zanylane/obdii-gps-heads-up-display/README.md

# obdii-gps-heads-up-display
This was a box we made for senior design to integrate with a car's OBD-II port and an optional GPS to get speed for displaying on the windshield.
