zanylane/obdii-gps-heads-up-display/KiCad/BOM.pdf

Ref | Value | Part Number | Price @ 1000 Source
C1 | 10uF | 81-GRM21BR61E106KA3L | $0.13
C2 | .01uF | 581-06033A100K | $0.05
C3 | 100nF | 77-VJ0603V104ZXAPBC | $0.03
C4 | 100nF | 77-VJ0603V104ZXAPBC | $0.03
C5 | 100nF | 77-VJ0603V104ZXAPBC | $0.03
C6 | 220uF | 598-AVE227M10X16T-F | $0.07
C7 | 100nF | 77-VJ0603V104ZXAPBC | $0.03
C8 | 30pF | 80-C0603C300J5G | $0.01
C9 | 30pF | 80-C0603C300J5G | $0.01
C10 | 100nF | 77-VJ0603V104ZXAPBC | $0.03
C11 | 100nF | 77-VJ0603V104ZXAPBC | $0.03
C12 | 560pF | 81-GRM185C1E561JA01D | $0.02
C13 | 560pF | 81-GRM185C1E561JA01D | $0.02
C14 | 100nF | 77-VJ0603V104ZXAPBC | $0.03
C15 | 100nF | 77-VJ0603V104ZXAPBC | $0.03
C16 | 10uF | 81-GRM21BR61E106KA3L | $0.13
C17 | 100nF | 77-VJ0603V104ZXAPBC | $0.03
C18 | 100nF | 77-VJ0603V104ZXAPBC | $0.03
C19 | 10uF | 80-C0603C103K3R | $0.01
C20 | 30pF | 80-C0603C300J5G | $0.01
C21 | 30pF | 80-C0603C300J5G | $0.01
C22 | 30pF | 80-C0603C300J5G | $0.01
C23 | 30pF | 80-C0603C300J5G | $0.01
D1 | DIODE | 78-1N4148W-VGS18 | $0.04
D2 | DIODE | 78-1N4148W-VGS18 | $0.04
D3 | DIODE | 78-1N4148W-VGS18 | $0.04
D4 | 25V ZENER | 863-MMSZ4710T1G | $0.10
D5 | | 625-BD340A-E3/61T | $0.15
D6 | DIODE | 625-SRP300B-E3 | $0.15
D7 | DIODE | 625-SRP300B-E3 | $0.15
F1 | 3.6A | 576-2920L185 | $0.30
F2 | 1A | 576-1812L110PRT | $0.19
IC1 | ATMEGA328P-A | 556-ATMEGA328P-AU | $2.77
IC2 | SC16IS740 | 771-SC16IS740IPWQ900 | $1.40
IC3 | LM339 | 595-LM339PWR | $0.11
IC4 | LM317-8 | 863-LM317LDG | $0.14
IC5 | SCANTOOL | STN1110 | $7.99
IC6 | MCP2551 | 579-MCP2551-I/SN | $0.78
IC7 | TPS5430 | 595-TPS5430DDA | $2.99
IC8 | TPS77633 | 595-TPS77633D | $1.21
J1 | AVR-ISP-6 | 517-30306-6002HB | $0.29
J2
J3 | | 571-5555167-1 | $0.55
J3 | | 678-300268 | $0.29
J4 | User Interface | 798-DF3A-6P-2DS10 | $0.11
J4 | User Interface | 798-DF3-6S-2C | $0.06
J5 | | 798-DF3-4S-2C16 | $0.04
J5 | | 798-DF3A-4P-2DS10 | $0.08
J6 | DB9 | 152-3309 | $0.92

Mouser.com
Mouser.com
Mouser.com
Mouser.com
Mouser.com
Mouser.com
Mouser.com
Mouser.com
Mouser.com
Mouser.com
Mouser.com
Mouser.com
Mouser.com
Mouser.com
Mouser.com
Mouser.com
Mouser.com
Mouser.com
Mouser.com
Mouser.com
Mouser.com
Mouser.com
Mouser.com
Mouser.com
Mouser.com
Mouser.com
Mouser.com
40V 3A Schottky | Mouser.com
| Mouser.com
| Mouser.com
| Mouser.com
| Mouser.com
| Mouser.com
| Mouser.com
| Mouser.com
| Mouser.com
| Scantools.net
| Mouser.com
| Mouser.com
| Mouser.com
| Mouser.com
Spare Cnct Pts
RJ45 GPS Cnct | Mouser.com
RJ45 GPS Cnct | Mouser.com
| Mouser.com
| Mouser.com
Pwr Switch Cnct. | Mouser.com
Pwr Switch Cnct. | Mouser.com
| Mouser.com

J7 | LED Display | 517-30316-5002 | $0.66
J7 | | 517-3603/16 | $0.45
J7 | LED Display | 538-54597-1600 | $0.14
J8 | Power Jack | 806-KLDX-0202-A | $0.31
L1 | 10uH | 810-MLF1608E100M | $0.05
L2 | 100uH | 810-VLCF528T101MR332 | $0.64
LED1 | LED | 859-LTST-C190GKT | $0.04
LED2 | LED | 859-LTST-C190GKT | $0.04
LED3 | LED | 859-LTST-C190GKT | $0.04
LED4 | LED | 859-LTST-C190GKT | $0.04
LED5 | LED | 859-LTST-C190GKT | $0.04
Q1 | NPN | 512-MMBT3646 | $0.02
Q2 | MOSFET_N | 771-2N7002BK215 | $0.03
Q3 | PNP | 512-MMBT3640 | $0.20
Q4 | NPN | 512-MMBT3646 | $0.02
Q5 | NPN | 512-MMBT3906 | $0.01
Q6 | NPN | 512-MMBT3906 | $0.01
Q7 | NPN | 512-MMBT3646 | $0.02
Q8 | NPN | 512-MMBT3646 | $0.02
R1 | 3.24k | 71-TNPW06033K24BEEN | $0.41
R2 | 10k | 301-10K-RC | $0.00
R3 | 10K | 301-10K-RC | $0.00
R4 | 10K | 301-10K-RC | $0.00
R5 | 10K | 301-10K-RC | $0.00
R6 | 1k | 667-ERJ-3GEYJ102V | $0.00
R7 | 1k | 667-ERJ-3GEYJ102V | $0.00
R8 | 10K | 301-10K-RC | $0.00
R9 | 10K | 301-10K-RC | $0.00
R10 | 10K | 301-10K-RC | $0.00
R11 | 10K | 301-10K-RC | $0.00
R12 | 10K | 301-10K-RC | $0.00
R13 | 10K | 301-10K-RC | $0.00
R14 | 2K | 660-RK73B1JTTD202J | $0.02
R15 | 8K | 302-8.06K-RC | $0.02
R16 | 10K | 301-10K-RC | $0.00
R17 | 10K | 301-10K-RC | $0.00
R18 | 10K | 301-10K-RC | $0.00
R19 | 240 | 652-CR0603-JW-241ELF | $0.01
R20 | 866 | 71-CRCW0805-866-E3 | $0.02
R21 | 374 | 71-CRCW0603-374-E3 | $0.02
R22 | 10K | 301-10K-RC | $0.00
R23 | 2.2K | 652-CR0603-JW-222ELF | $0.01
R24 | 10K | 301-10K-RC | $0.00
R25 | 10K | 301-10K-RC | $0.00
R26 | 1k | 667-ERJ-3GEYJ102V | $0.00
R27 | 1k | 667-ERJ-3GEYJ102V | $0.00
R28 | 510 | 660-RK73B2ETTE511J | $0.07
R29 | 510 | 660-RK73B2ETTE511J | $0.07
R30 | 10k | 301-10K-RC | $0.00
R31 | 1k | 667-ERJ-3GEYJ102V | $0.00

Mouser.com
Disp. Ribbon Cable | Mouser.com
| Mouser.com
| Mouser.com
| Mouser.com
| Mouser.com
| Mouser.com
| Mouser.com
| Mouser.com
| Mouser.com
| Mouser.com
| Mouser.com
| Mouser.com
| Mouser.com
| Mouser.com
| Mouser.com
| Mouser.com
| Mouser.com
| Mouser.com
| Mouser.com
| Mouser.com
| Mouser.com
| Mouser.com
| Mouser.com
| Mouser.com
| Mouser.com
| Mouser.com
| Mouser.com
| Mouser.com
| Mouser.com
| Mouser.com
| Mouser.com
| Mouser.com
| Mouser.com
| Mouser.com
| Mouser.com
| Mouser.com
| Mouser.com
| Mouser.com
| Mouser.com
| Mouser.com
| Mouser.com
| Mouser.com
| Mouser.com
| Mouser.com
| Mouser.com
| Mouser.com
| Mouser.com
| Mouser.com
| Mouser.com

R32 | 4.7k | 71-CRCW0603J-4.7K-E3 | $0.02
R33 | 100 | 652-CR0603-JW-101GLF | $0.01
R34 | 100 | 652-CR0603-JW-101GLF | $0.01
R35 | 10k | 301-10K-RC | $0.00
R36 | 62k | 71-CRCW0603-62K-E3 | $0.02
R37 | 10k | 301-10K-RC | $0.00
R38 | 10 | 667-ERJ-3GEYJ100V | $0.00
R39 | 1k | 667-ERJ-3GEYJ102V | $0.00
R40 | 1k | 667-ERJ-3GEYJ102V | $0.00
R41 | 1k | 667-ERJ-3GEYJ102V | $0.00
R42 | 1k | 667-ERJ-3GEYJ102V | $0.00
R43 | 100k | 667-ERJ-3GEYJ104V | $0.00
R44 | 1k | 667-ERJ-3GEYJ102V | $0.00
R45 | 1.5k | 667-ERJ-3GEYJ152V | $0.00
R46 | 4.7k | 667-ERJ-3EKF2202V | $0.00
R47 | 10k | 301-10K-RC | $0.00
R48 | 10k | 301-10K-RC | $0.00
R49 | 1k | 667-ERJ-3GEYJ102V | $0.00
R50 | 1k | 667-ERJ-3GEYJ102V | $0.00
X1 | | 815-ABLS-16.0M-T | $0.15
X2 | | 815-ABLS-16.0M-T | $0.15
X3 | | 815-ABLS-14.7456M-T | $0.15
| Rotary Encoder | 652-PEC11-4220F-S24 | $0.77
| Power Switch | 629-AA211B31 | $0.49
| LED Display | DE-DP14112 | $23.90
$7.00 | estimate
Case Plastic | $2.00 | estimate

Mouser.com
Mouser.com
Mouser.com
Mouser.com
Mouser.com
Mouser.com
Mouser.com
Mouser.com
Mouser.com
Mouser.com
Mouser.com
Mouser.com
Mouser.com
Mouser.com
Mouser.com
Mouser.com
Mouser.com
Mouser.com
Mouser.com
16 MHz Xtal | Mouser.com
16 MHz Xtal | Mouser.com
14.7456 MHz Xtal | Mouser.com
| Mouser.com
| Mouser.com
| SureElectronics.net
Case Moulds
