zanylane/obdii-gps-heads-up-display/case/PowerSwitch.SLDPRT

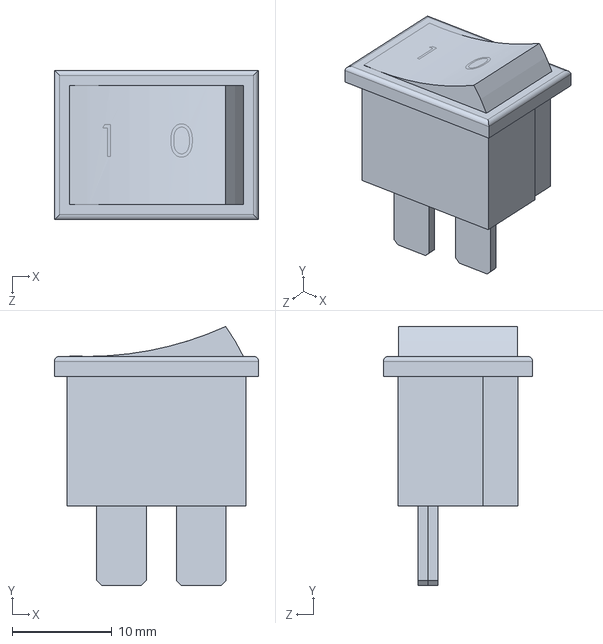
[picture p16: CAD file, 2018-04-19]
case/PowerSwitch.SLDPRT
20.5 x 26.0 x 15.0 mm
