zanylane/obdii-gps-heads-up-display/case/RotaryEncoderKnob.SLDPRT

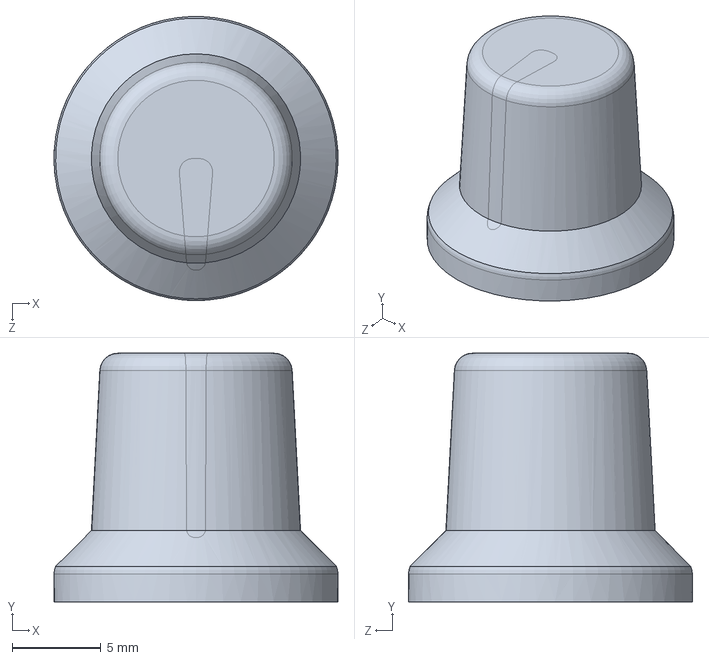
[picture p17: CAD file, 2018-04-19]
case/RotaryEncoderKnob.SLDPRT
16.0 x 14.0 x 16.0 mm
