zanylane/obdii-gps-heads-up-display/case/RotaryEncoder.SLDPRT

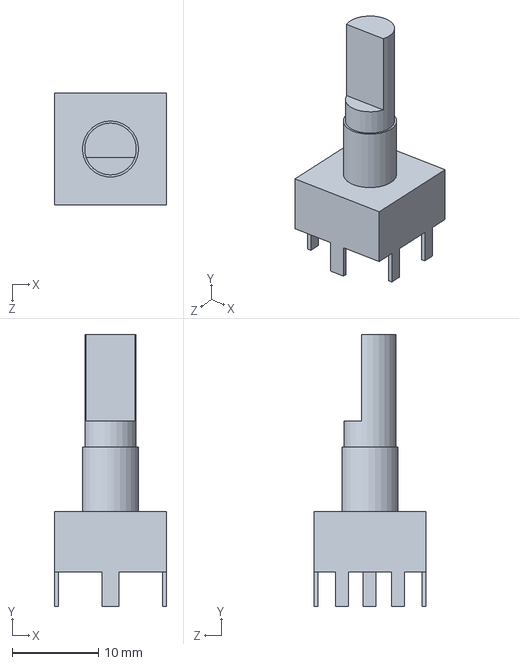
[picture p18: CAD file, 2018-04-19]
case/RotaryEncoder.SLDPRT
13.0 x 31.5 x 13.0 mm
