zanylane/obdii-gps-heads-up-display/(list of files, cad)

Other CAD files:
case/Assem1.SLDDRW
case/PowerSwitch.SLDDRW
case/RotaryEncoder.SLDDRW
case/RotaryEncoderKnob.SLDDRW
case/bottom.SLDDRW
case/box.SLDDRW
case/led_display.SLDDRW
case/pcb.SLDDRW
