zanylane/obdii-gps-heads-up-display/case/Assem1 - Sheet1.pdf

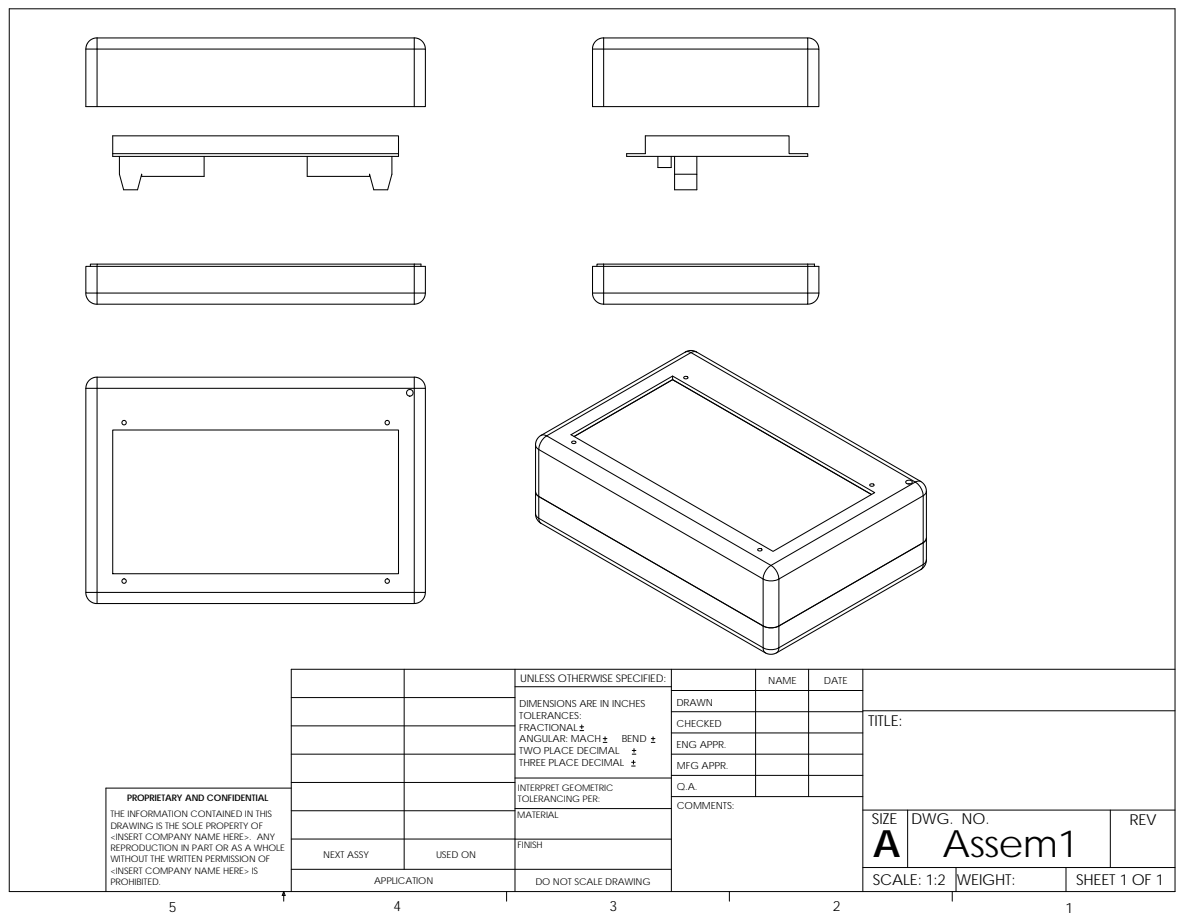
[picture p20: page 1]
COMMENTS:; BEND

UNLESS OTHERWISE SPECIFIED: | | NAME | DATE

DRAWN
CHECKED | | | TITLE:

DIMENSIONS ARE IN INCHES
TOLERANCES:
FRACTIONAL
ANGULAR: MACH
TWO PLACE DECIMAL
THREE PLACE DECIMAL

ENG APPR.
MFG APPR.

INTERPRET GEOMETRIC TOLERANCING PER: | Q.A.
MATERIAL | | SIZE A | DWG. NO. Assem1 | REV

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

NEXT ASSY | USED ON | FINISH
APPLICATION | DO NOT SCALE DRAWING | | SCALE: 1:2 | WEIGHT: | SHEET 1 OF 1
