zanylane/obdii-gps-heads-up-display/case/bottom - Sheet1&2.pdf

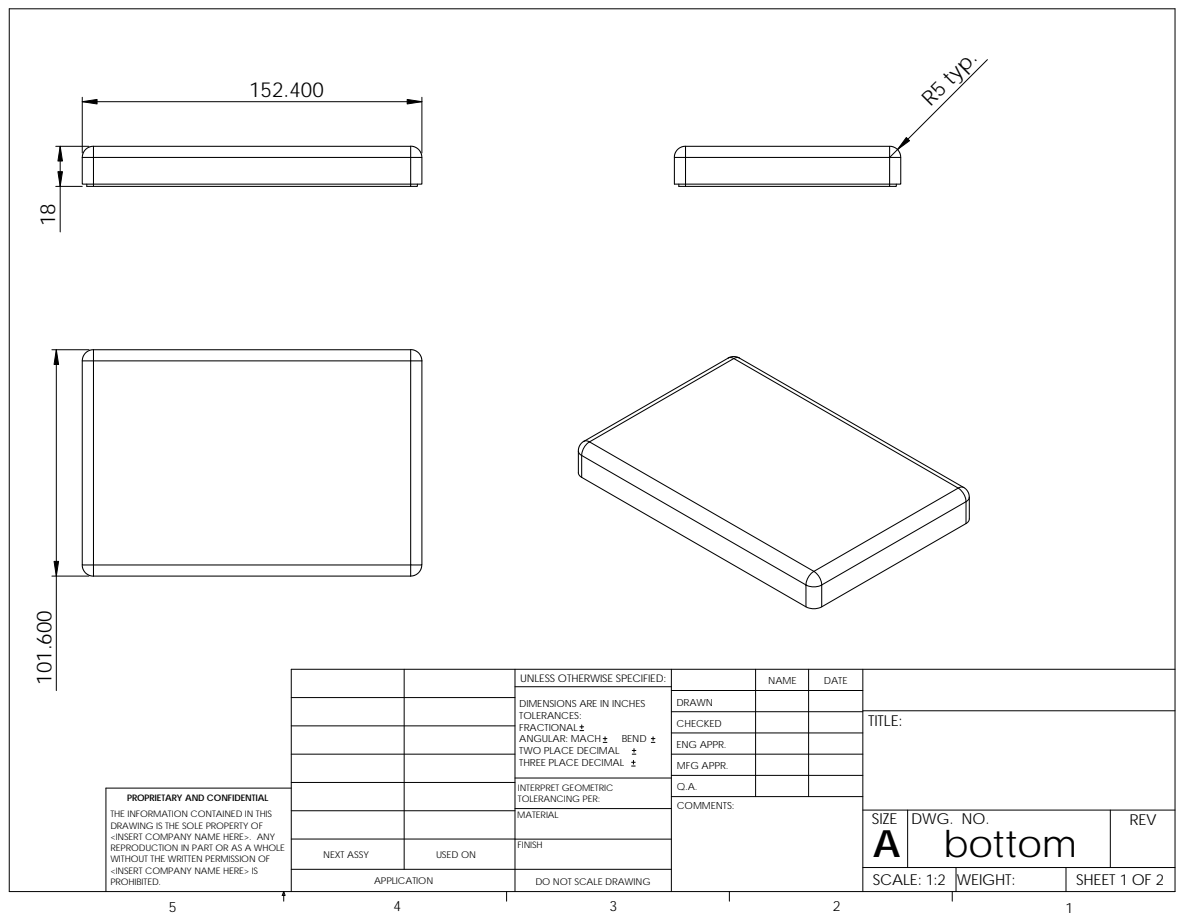
[picture p24: page 1]
R5 typ. 152.400; COMMENTS:; ANGULAR: MACH; BEND

UNLESS OTHERWISE SPECIFIED: | | NAME | DATE

DRAWN
CHECKED | | | TITLE:

DIMENSIONS ARE IN INCHES
TOLERANCES:
FRACTIONAL
TWO PLACE DECIMAL
THREE PLACE DECIMAL

ENG APPR.
MFG APPR.

INTERPRET GEOMETRIC TOLERANCING PER: | Q.A.
MATERIAL | | SIZE A | DWG. NO. bottom | REV

PROPRIETARY AND CONFIDENTIAL
THE INFORMATION CONTAINED IN THIS
DRAWING IS THE SOLE PROPERTY OF
<INSERT COMPANY NAME HERE>. ANY
REPRODUCTION IN PART OR AS A WHOLE
WITHOUT THE WRITTEN PERMISSION OF
<INSERT COMPANY NAME HERE> IS
PROHIBITED.

NEXT ASSY | USED ON | FINISH

APPLICATION | DO NOT SCALE DRAWING | | SCALE: 1:2 | WEIGHT: | SHEET 1 OF 2

1
B

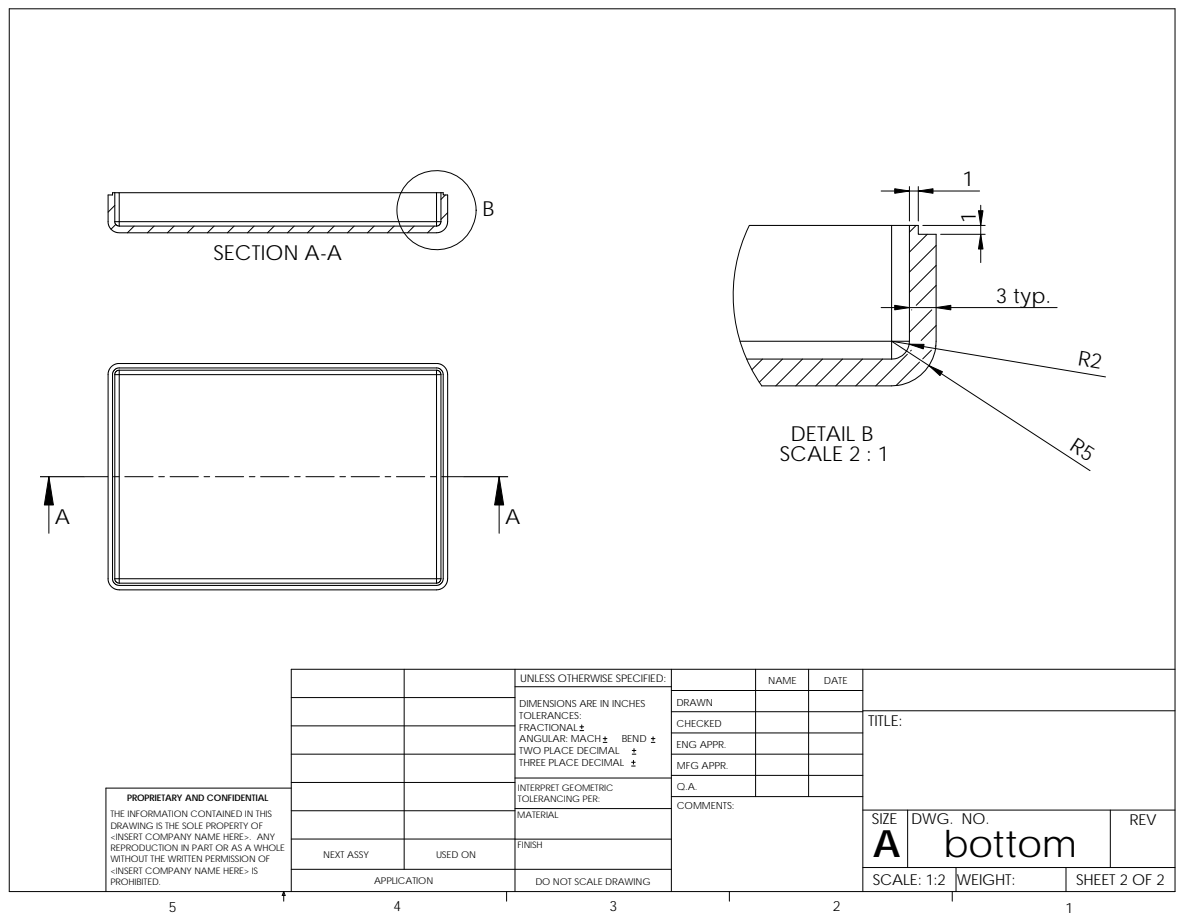
[picture p25: page 2]
DETAIL B SCALE 2 : 1; 3 typ.; COMMENTS:; ANGULAR: MACH; BEND; SECTION A-A

UNLESS OTHERWISE SPECIFIED: | | NAME | DATE

DRAWN
CHECKED | | | TITLE:

DIMENSIONS ARE IN INCHES
TOLERANCES:
FRACTIONAL
TWO PLACE DECIMAL
THREE PLACE DECIMAL

ENG APPR.
MFG APPR.

INTERPRET GEOMETRIC TOLERANCING PER: | Q.A.
MATERIAL | | SIZE A | DWG. NO. bottom | REV

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

NEXT ASSY | USED ON | FINISH

APPLICATION | DO NOT SCALE DRAWING | | SCALE: 1:2 | WEIGHT: | SHEET 2 OF 2
