zanylane/obdii-gps-heads-up-display/case/box_top - Sheet1&2.pdf

152.400 | R5

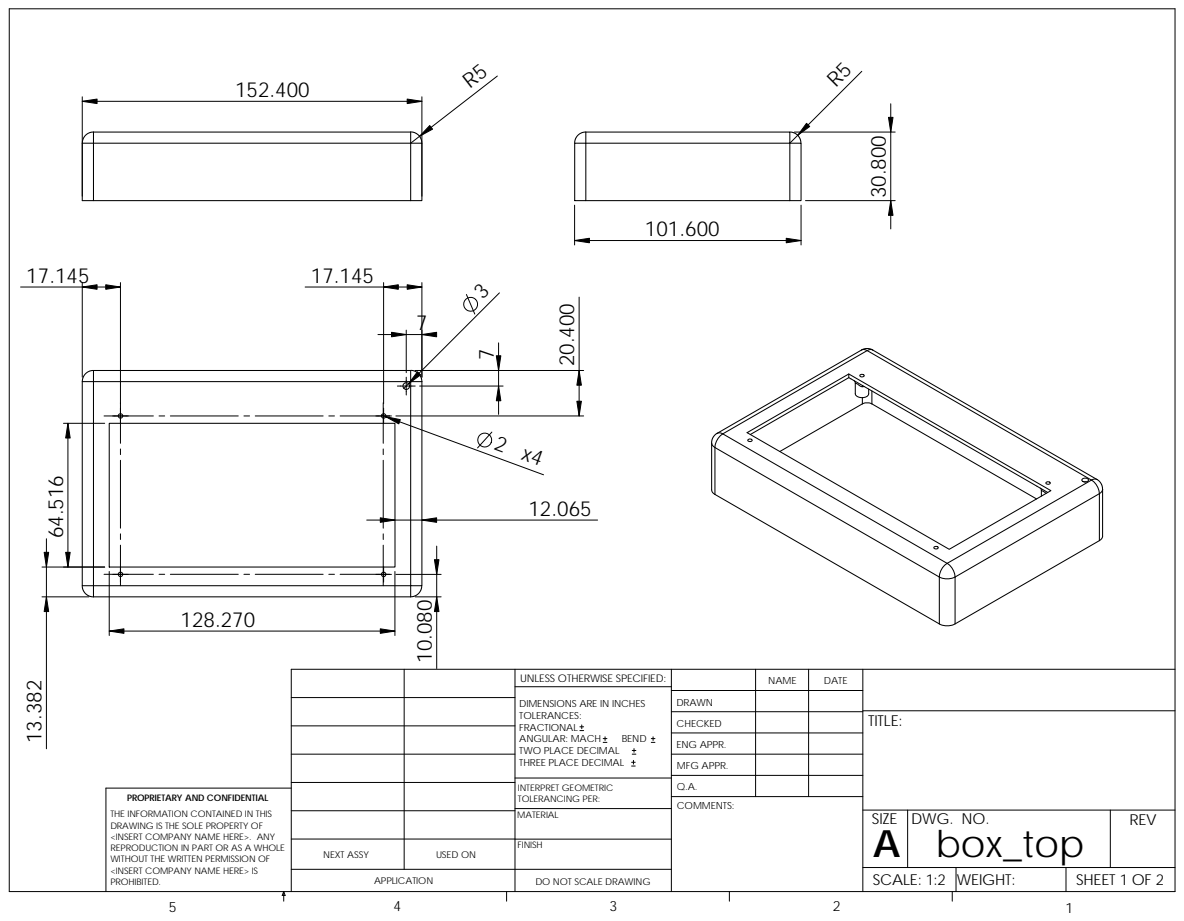
[picture p26: page 1]
COMMENTS:; BEND

UNLESS OTHERWISE SPECIFIED: | | NAME | DATE

DRAWN
CHECKED | | | TITLE:

DIMENSIONS ARE IN INCHES
TOLERANCES:
FRACTIONAL
ANGULAR: MACH
TWO PLACE DECIMAL
THREE PLACE DECIMAL

ENG APPR.
MFG APPR.

INTERPRET GEOMETRIC TOLERANCING PER: | Q.A.
MATERIAL | | SIZE A | DWG. NO. box_top | REV

PROPRIETARY AND CONFIDENTIAL
THE INFORMATION CONTAINED IN THIS
DRAWING IS THE SOLE PROPERTY OF
<INSERT COMPANY NAME HERE>. ANY
REPRODUCTION IN PART OR AS A WHOLE
WITHOUT THE WRITTEN PERMISSION OF
<INSERT COMPANY NAME HERE> IS
PROHIBITED.

NEXT ASSY | USED ON | FINISH

APPLICATION | DO NOT SCALE DRAWING | | SCALE: 1:2 | WEIGHT: | SHEET 1 OF 2

# SECTION A-A

# 2 typ thickness

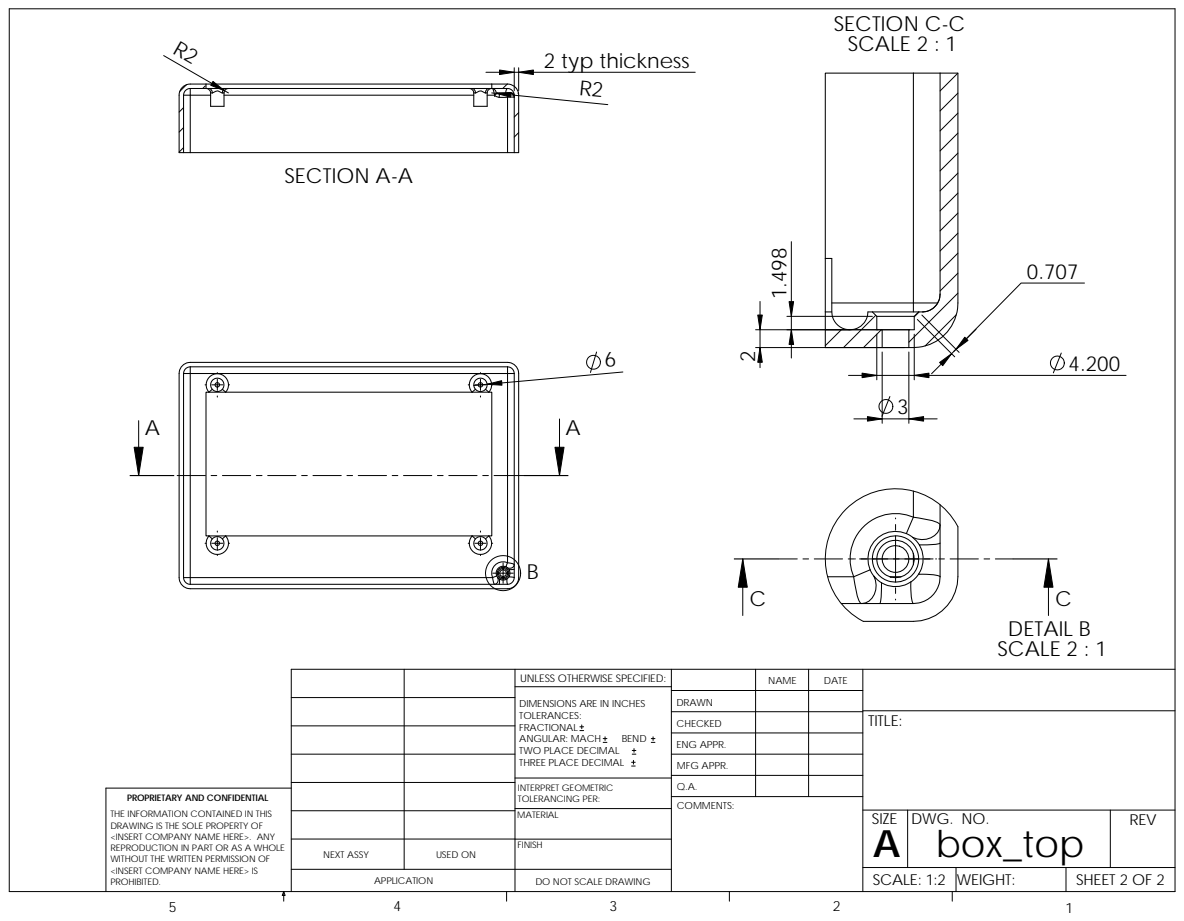
[picture p27: page 2]
COMMENTS:; BEND; SECTION C-C SCALE 2 : 1; DETAIL B SCALE 2 : 1

UNLESS OTHERWISE SPECIFIED: | | NAME | DATE

DRAWN
CHECKED | | | TITLE:

DIMENSIONS ARE IN INCHES
TOLERANCES:
FRACTIONAL
ANGULAR: MACH
TWO PLACE DECIMAL
THREE PLACE DECIMAL

ENG APPR.
MFG APPR.

INTERPRET GEOMETRIC TOLERANCING PER: | Q.A.
MATERIAL | | SIZE A | DWG. NO. box_top | REV

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

NEXT ASSY | USED ON | FINISH
APPLICATION | DO NOT SCALE DRAWING | | SCALE: 1:2 | WEIGHT: | SHEET 2 OF 2
