zanylane/obdii-gps-heads-up-display/KiCad/GPS_Module.sch

## KiCad design KiCad/GPS_Module.sch (2018-04-19)

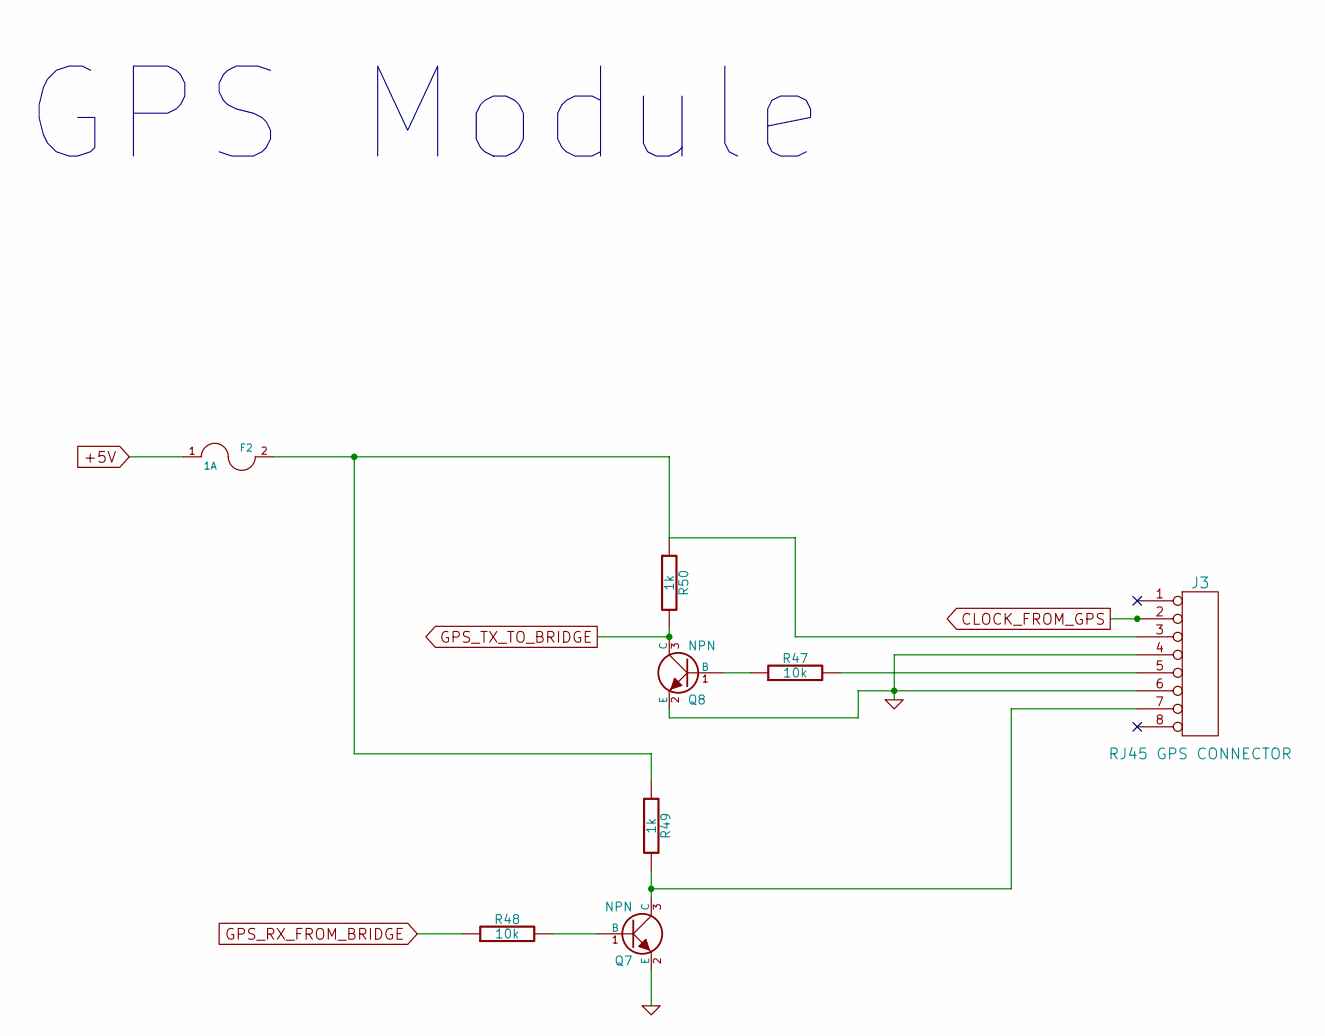
[picture p39: schematic GPS_Module.sch]

Parts:
F2: 1A
J3: RJ45 GPS CONNECTOR
Q7, Q8: NPN
R47, R48: 10k
R49, R50: 1k

Connections:
+5V: F2.1
CLOCK_FROM_GPS: J3.2
GND: J3.4, J3.6, Q7.2 (E), Q8.2 (E)
GPS_RX_FROM_BRIDGE: R48.1
GPS_TX_TO_BRIDGE: Q8.3 (C), R50.2
unnamed: F2.2, J3.3, R49.1, R50.1
unnamed: J3.5, R47.2
unnamed: J3.7, Q7.3 (C), R49.2
unnamed: Q7.1 (B), R48.2
unnamed: Q8.1 (B), R47.1

Notes on the sheet:
GPS Module
