zanylane/obdii-gps-heads-up-display/KiCad/I2C_Bridge.sch

## KiCad design KiCad/I2C_Bridge.sch (2018-04-19)

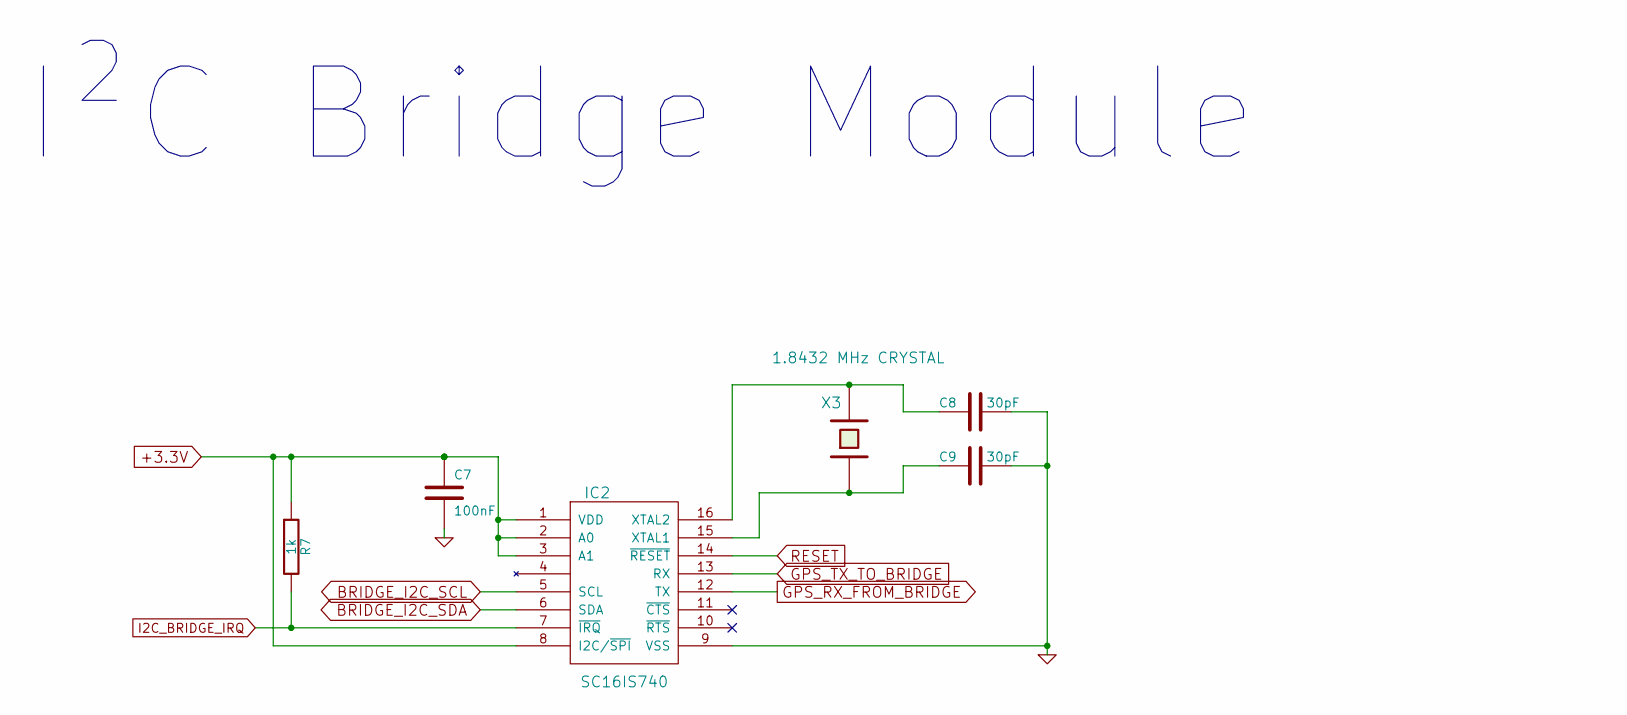
[picture p40: schematic I2C_Bridge.sch]

Parts:
C7: 100nF
C8, C9: 30pF
IC2: SC16IS740
R7: 1k
X3: 1.8432 MHz CRYSTAL

Connections:
+3.3V: C7.1, IC2.1 (VDD), IC2.2 (A0), IC2.3 (A1), IC2.8 (I2C/~SPI), R7.1
BRIDGE_I2C_SCL: IC2.5 (SCL)
BRIDGE_I2C_SDA: IC2.6 (SDA)
GND: C7.2, C8.2, C9.2, IC2.9 (VSS)
GPS_RX_FROM_BRIDGE: IC2.12 (TX)
GPS_TX_TO_BRIDGE: IC2.13 (RX)
I2C_BRIDGE_IRQ: IC2.7 (~IRQ), R7.2
unnamed: C8.1, IC2.16 (XTAL2), X3.2
unnamed: C9.1, IC2.15 (XTAL1), X3.1
RESET: IC2.14 (~RESET)

Notes on the sheet:
I²C Bridge Module
