zanylane/obdii-gps-heads-up-display/KiCad/Microprocessor.sch

## KiCad design KiCad/Microprocessor.sch (2018-04-19)

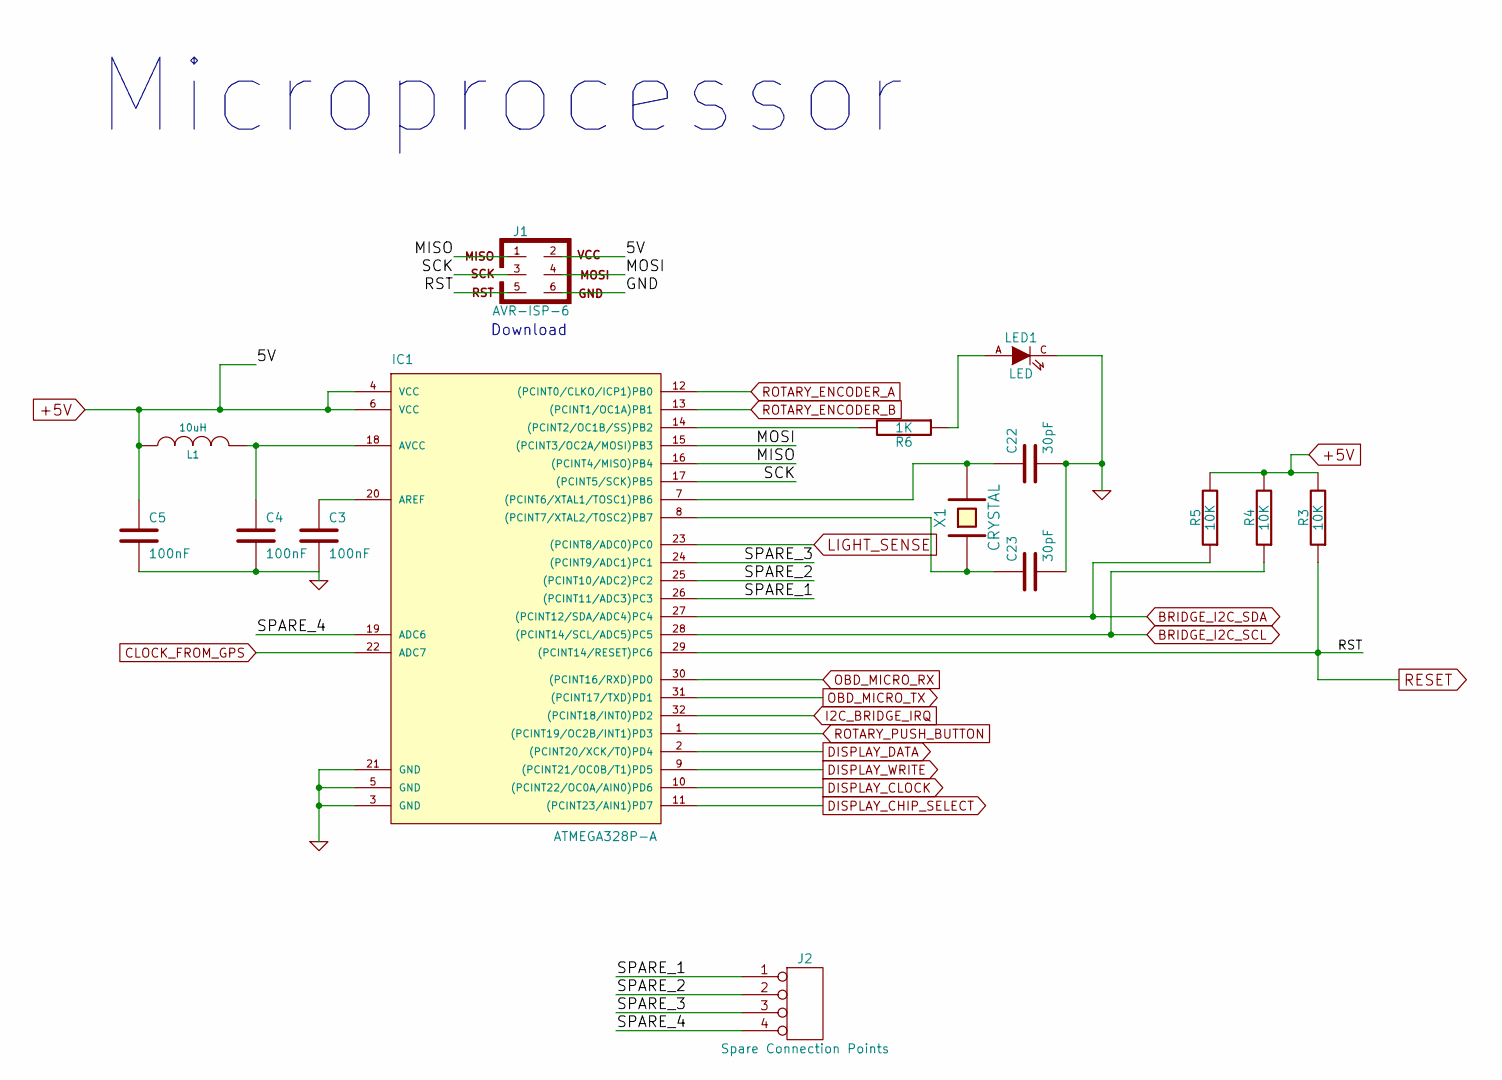
[picture p41: schematic Microprocessor.sch]

Parts:
C3, C4, C5: 100nF
C22, C23: 30pF
IC1: ATMEGA328P-A; TQFP32
J1: AVR-ISP-6
J2: Spare Connection Points
L1: 10uH
LED1: LED
R3, R4, R5: 10K
R6: 1K
X1: CRYSTAL

Connections:
+5V: C5.1, IC1.4 (VCC), IC1.6 (VCC), J1.2, L1.1, R3.2, R4.2, R5.2
BRIDGE_I2C_SCL: IC1.28 ((PCINT14/SCL/ADC5)PC5), R4.1
BRIDGE_I2C_SDA: IC1.27 ((PCINT12/SDA/ADC4)PC4), R5.1
CLOCK_FROM_GPS: IC1.22 (ADC7)
DISPLAY_CHIP_SELECT: IC1.11 ((PCINT23/AIN1)PD7)
DISPLAY_CLOCK: IC1.10 ((PCINT22/OC0A/AIN0)PD6)
DISPLAY_DATA: IC1.2 ((PCINT20/XCK/T0)PD4)
DISPLAY_WRITE: IC1.9 ((PCINT21/OC0B/T1)PD5)
GND: C3.2, C4.2, C5.2, C22.2, C23.2, IC1.3 (GND), IC1.5 (GND), IC1.21 (GND), J1.6, LED1.C
I2C_BRIDGE_IRQ: IC1.32 ((PCINT18/INT0)PD2)
LIGHT_SENSE: IC1.23 ((PCINT8/ADC0)PC0)
MISO: IC1.16 ((PCINT4/MISO)PB4), J1.1
MOSI: IC1.15 ((PCINT3/OC2A/MOSI)PB3), J1.4
unnamed: C3.1, IC1.20 (AREF)
unnamed: C4.1, IC1.18 (AVCC), L1.2
unnamed: C22.1, IC1.7 ((PCINT6/XTAL1/TOSC1)PB6), X1.2
unnamed: C23.1, IC1.8 ((PCINT7/XTAL2/TOSC2)PB7), X1.1
unnamed: IC1.14 ((PCINT2/OC1B/SS)PB2), R6.2
unnamed: LED1.A, R6.1
OBD_MICRO_RX: IC1.30 ((PCINT16/RXD)PD0)
OBD_MICRO_TX: IC1.31 ((PCINT17/TXD)PD1)
RESET: IC1.29 ((PCINT14/RESET)PC6), J1.5, R3.1
ROTARY_ENCODER_A: IC1.12 ((PCINT0/CLKO/ICP1)PB0)
ROTARY_ENCODER_B: IC1.13 ((PCINT1/OC1A)PB1)
ROTARY_PUSH_BUTTON: IC1.1 ((PCINT19/OC2B/INT1)PD3)
SCK: IC1.17 ((PCINT5/SCK)PB5), J1.3
SPARE_1: IC1.26 ((PCINT11/ADC3)PC3), J2.1
SPARE_2: IC1.25 ((PCINT10/ADC2)PC2), J2.2
SPARE_3: IC1.24 ((PCINT9/ADC1)PC1), J2.3
SPARE_4: IC1.19 (ADC6), J2.4

Notes on the sheet:
Microprocessor
Download
