zanylane/obdii-gps-heads-up-display/KiCad/OBD_Chip.sch

## KiCad design KiCad/OBD_Chip.sch (2018-04-19)

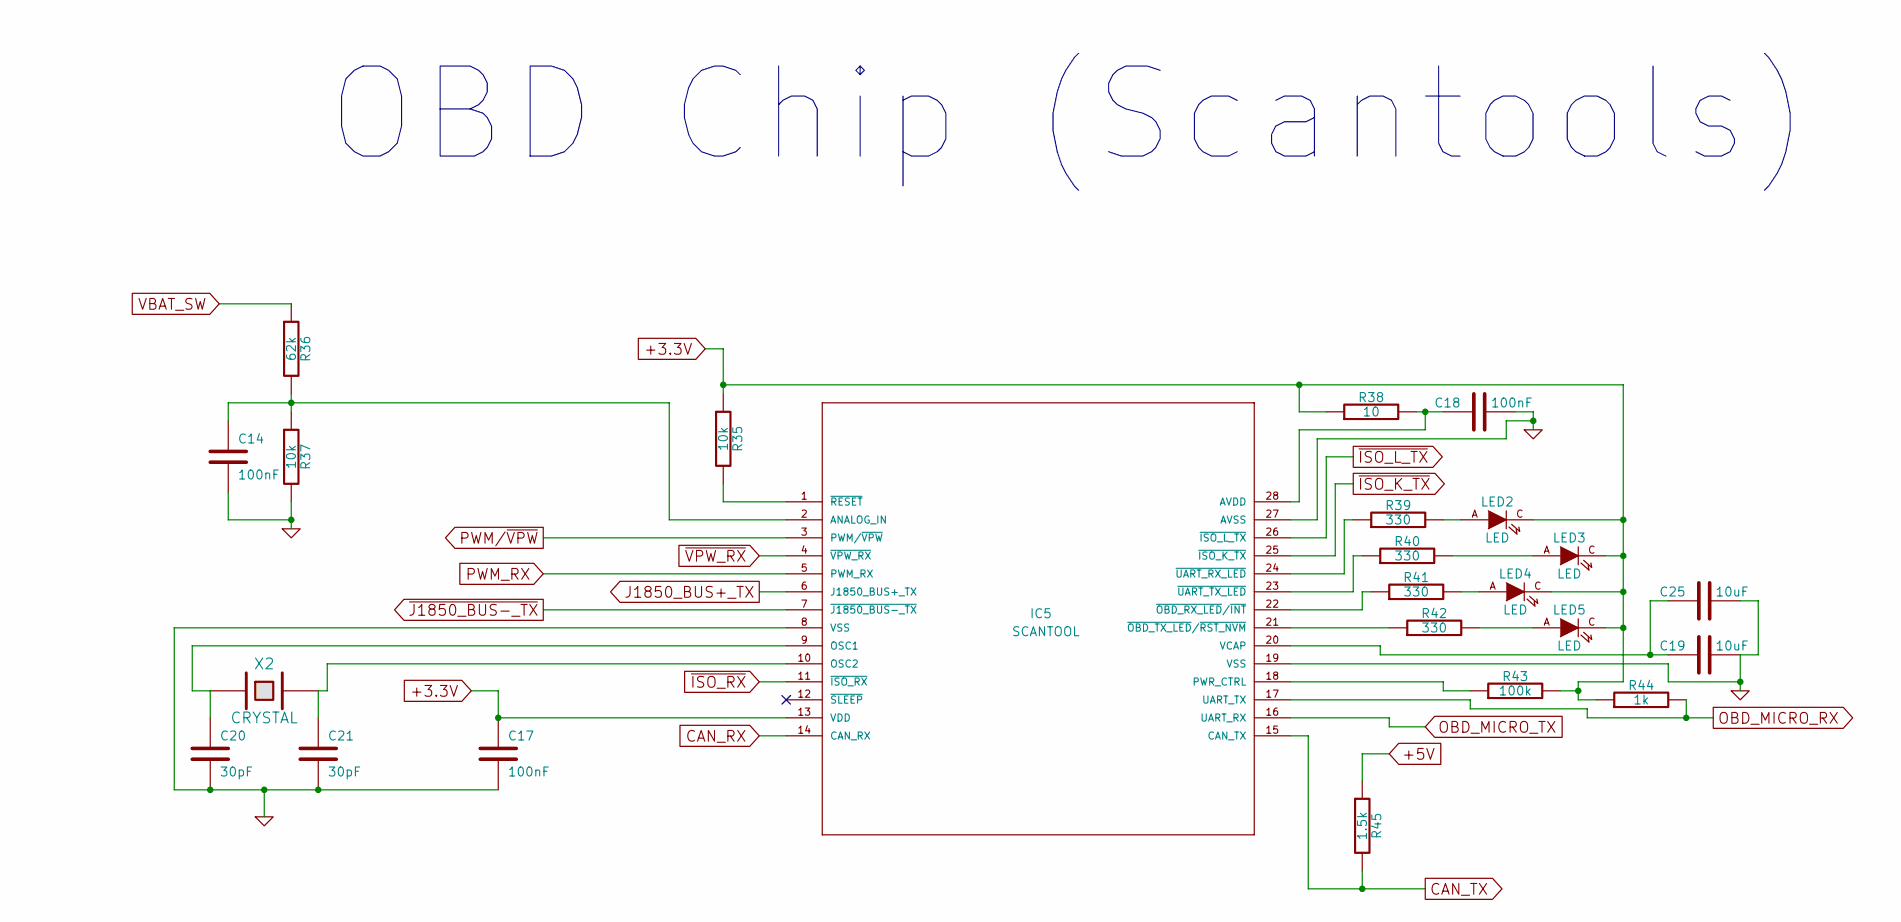
[picture p42: schematic OBD_Chip.sch]

Parts:
C14, C17, C18: 100nF
C19, C25: 10uF
C20, C21: 30pF
IC5: SCANTOOL; STN1110_-_SCANTOOL_SOIC
LED2, LED3, LED4, LED5: LED
R35, R37: 10k
R36: 62k
R38: 10
R39, R40, R41, R42: 330
R43: 100k
R44: 1k
R45: 1.5k
X2: CRYSTAL

Connections:
+3.3V: C17.1, IC5.13 (VDD), LED2.C, LED3.C, LED4.C, LED5.C, R35.1, R38.1, R43.2, R44.1
+5V: R45.1
CAN_RX: IC5.14 (CAN_RX)
CAN_TX: IC5.15 (CAN_TX), R45.2
GND: C14.2, C17.2, C18.2, C19.2, C20.2, C21.2, C25.2, IC5.8 (VSS), IC5.19 (VSS), IC5.27 (AVSS), R37.2
J1850_BUS+_TX: IC5.6 (J1850_BUS+_TX)
unnamed: C14.1, IC5.2 (ANALOG_IN), R36.2, R37.1
unnamed: C18.1, IC5.28 (AVDD), R38.2
unnamed: C19.1, C25.1, IC5.20 (VCAP)
unnamed: C20.1, IC5.9 (OSC1), X2.1
unnamed: C21.1, IC5.10 (OSC2), X2.2
unnamed: IC5.1 (~RESET), R35.2
unnamed: IC5.18 (PWR_CTRL), R43.1
unnamed: IC5.21 (~OBD_TX_LED~/~RST_NVM), R42.1
unnamed: IC5.22 (~OBD_RX_LED~/~INT), R41.1
unnamed: IC5.23 (~UART_TX_LED), R40.1
unnamed: IC5.24 (~UART_RX_LED), R39.1
unnamed: LED2.A, R39.2
unnamed: LED3.A, R40.2
unnamed: LED4.A, R41.2
unnamed: LED5.A, R42.2
OBD_MICRO_RX: IC5.17 (UART_TX), R44.2
OBD_MICRO_TX: IC5.16 (UART_RX)
PWM/~VPW: IC5.3 (PWM/~VPW)
PWM_RX: IC5.5 (PWM_RX)
VBAT_SW: R36.1
~ISO_K_TX: IC5.25 (~ISO_K_TX)
~ISO_L_TX: IC5.26 (~ISO_L_TX)
~ISO_RX: IC5.11 (~ISO_RX)
~J1850_BUS-_TX: IC5.7 (~J1850_BUS-_TX)
~VPW_RX: IC5.4 (~VPW_RX)

Notes on the sheet:
OBD Chip (Scantools)
