zanylane/obdii-gps-heads-up-display/KiCad/OBD_Voltage_Shifter1.sch

## KiCad design KiCad/OBD_Voltage_Shifter1.sch (2018-04-19)

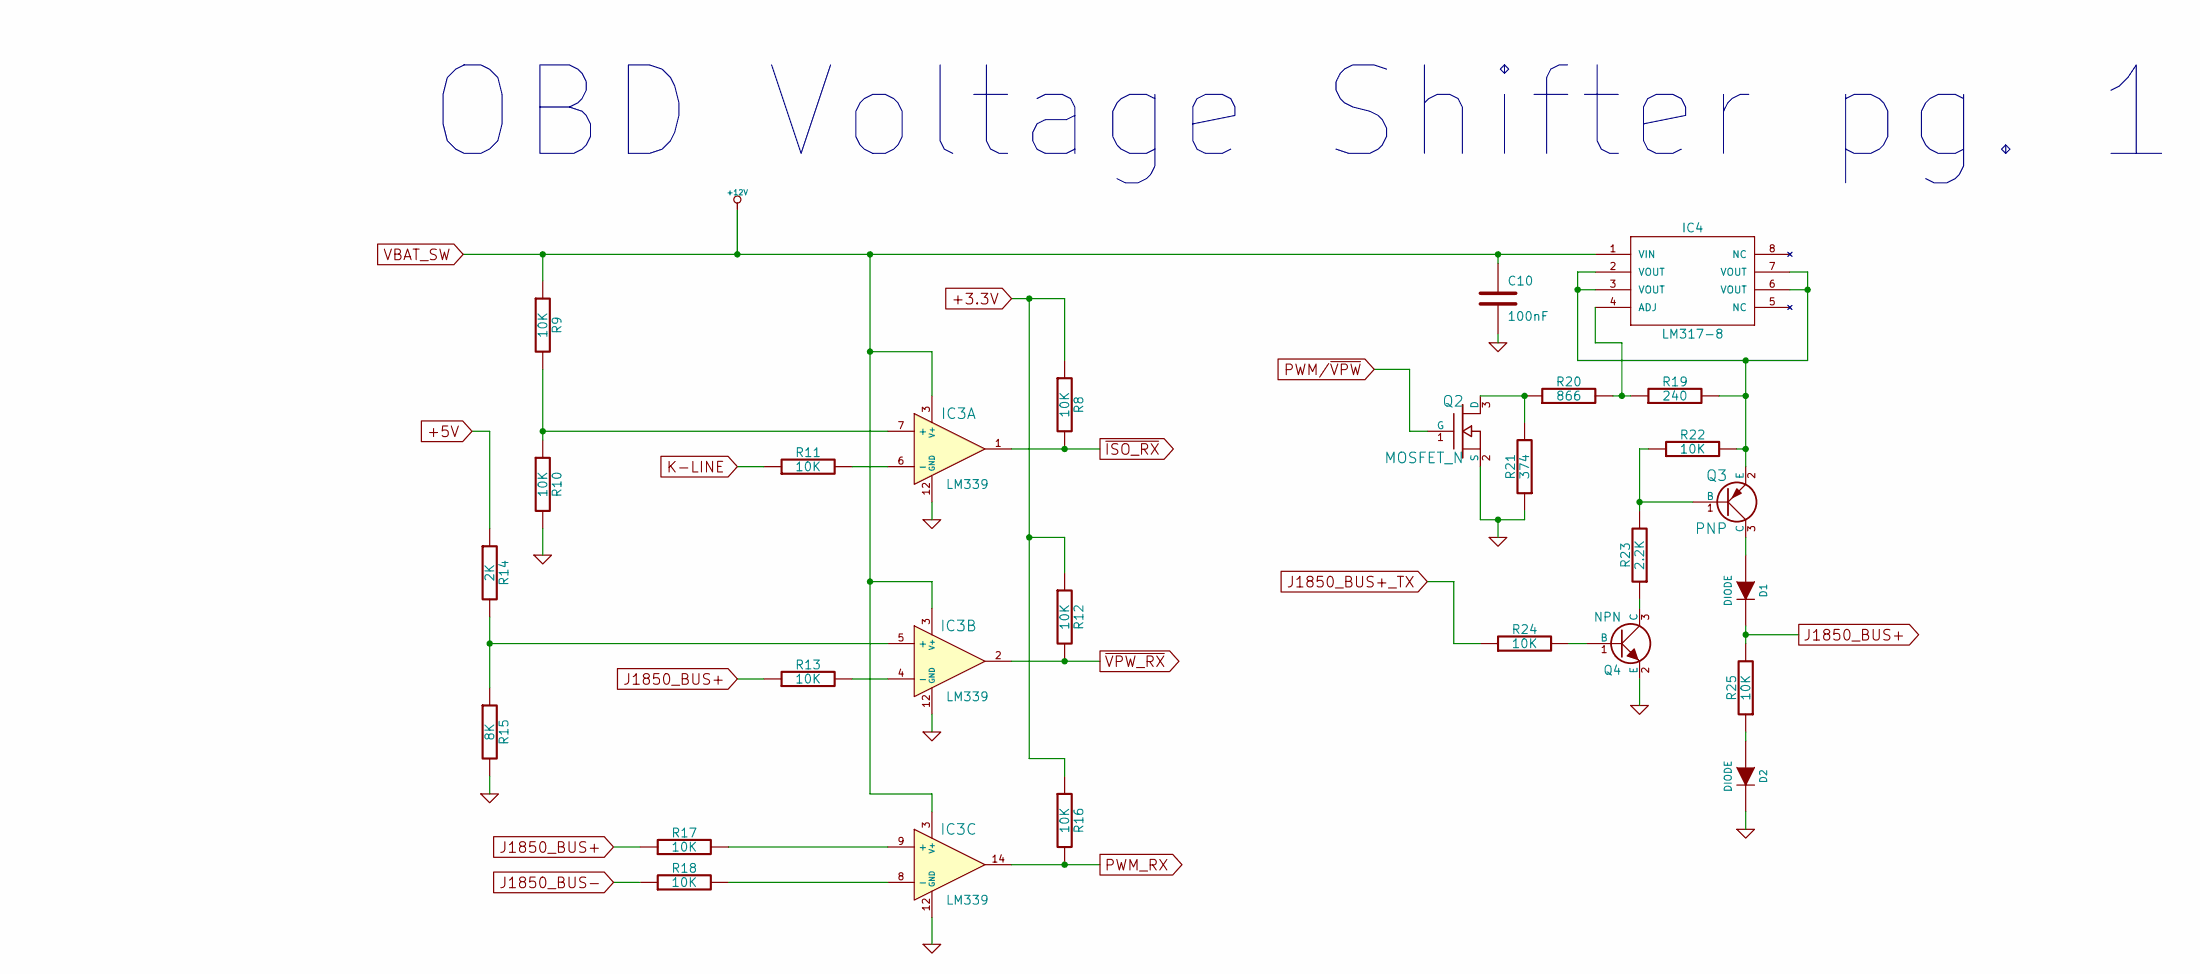
[picture p43: schematic OBD_Voltage_Shifter1.sch]

Parts:
C10: 100nF
D1, D2: DIODE
IC3: LM339
IC4: LM317-8
Q2: MOSFET_N
Q3: PNP
Q4: NPN
R8, R9, R10, R11, R12, R13, R16, R17, R18, R22, R24, R25: 10K
R14: 2K
R15: 8K
R19: 240
R20: 866
R21: 374
R23: 2.2K

Connections:
+3.3V: R8.1, R12.1, R16.1
+5V: R14.1
+12V: C10.1, IC3.3 (V+), IC4.1 (VIN), R9.1
GND: C10.2, D2.C, IC3.12 (GND), Q2.2 (S), Q4.2 (E), R10.2, R15.2, R21.1
J1850_BUS+: D1.C, R13.1, R17.1, R25.2
J1850_BUS+_TX: R24.1
J1850_BUS-: R18.1
K-LINE: R11.1
unnamed: D1.A, Q3.3 (C)
unnamed: D2.A, R25.1
unnamed: IC3.4 (-), R13.2
unnamed: IC3.5 (+), R14.2, R15.1
unnamed: IC3.6 (-), R11.2
unnamed: IC3.7 (+), R9.2, R10.1
unnamed: IC3.8 (-), R18.2
unnamed: IC3.9 (+), R17.2
unnamed: IC4.2 (VOUT), IC4.3 (VOUT), IC4.6 (VOUT), IC4.7 (VOUT), Q3.2 (E), R19.2, R22.2
unnamed: IC4.4 (ADJ), R19.1, R20.2
unnamed: Q2.3 (D), R20.1, R21.2
unnamed: Q3.1 (B), R22.1, R23.2
unnamed: Q4.1 (B), R24.2
unnamed: Q4.3 (C), R23.1
PWM/~VPW: Q2.1 (G)
PWM_RX: IC3.14, R16.2
~ISO_RX: IC3.1, R8.2
~VPW_RX: IC3.2, R12.2

Notes on the sheet:
OBD Voltage Shifter pg. 1
