zanylane/obdii-gps-heads-up-display/KiCad/OBD_Voltage_Shifter2.sch

## KiCad design KiCad/OBD_Voltage_Shifter2.sch (2018-04-19)

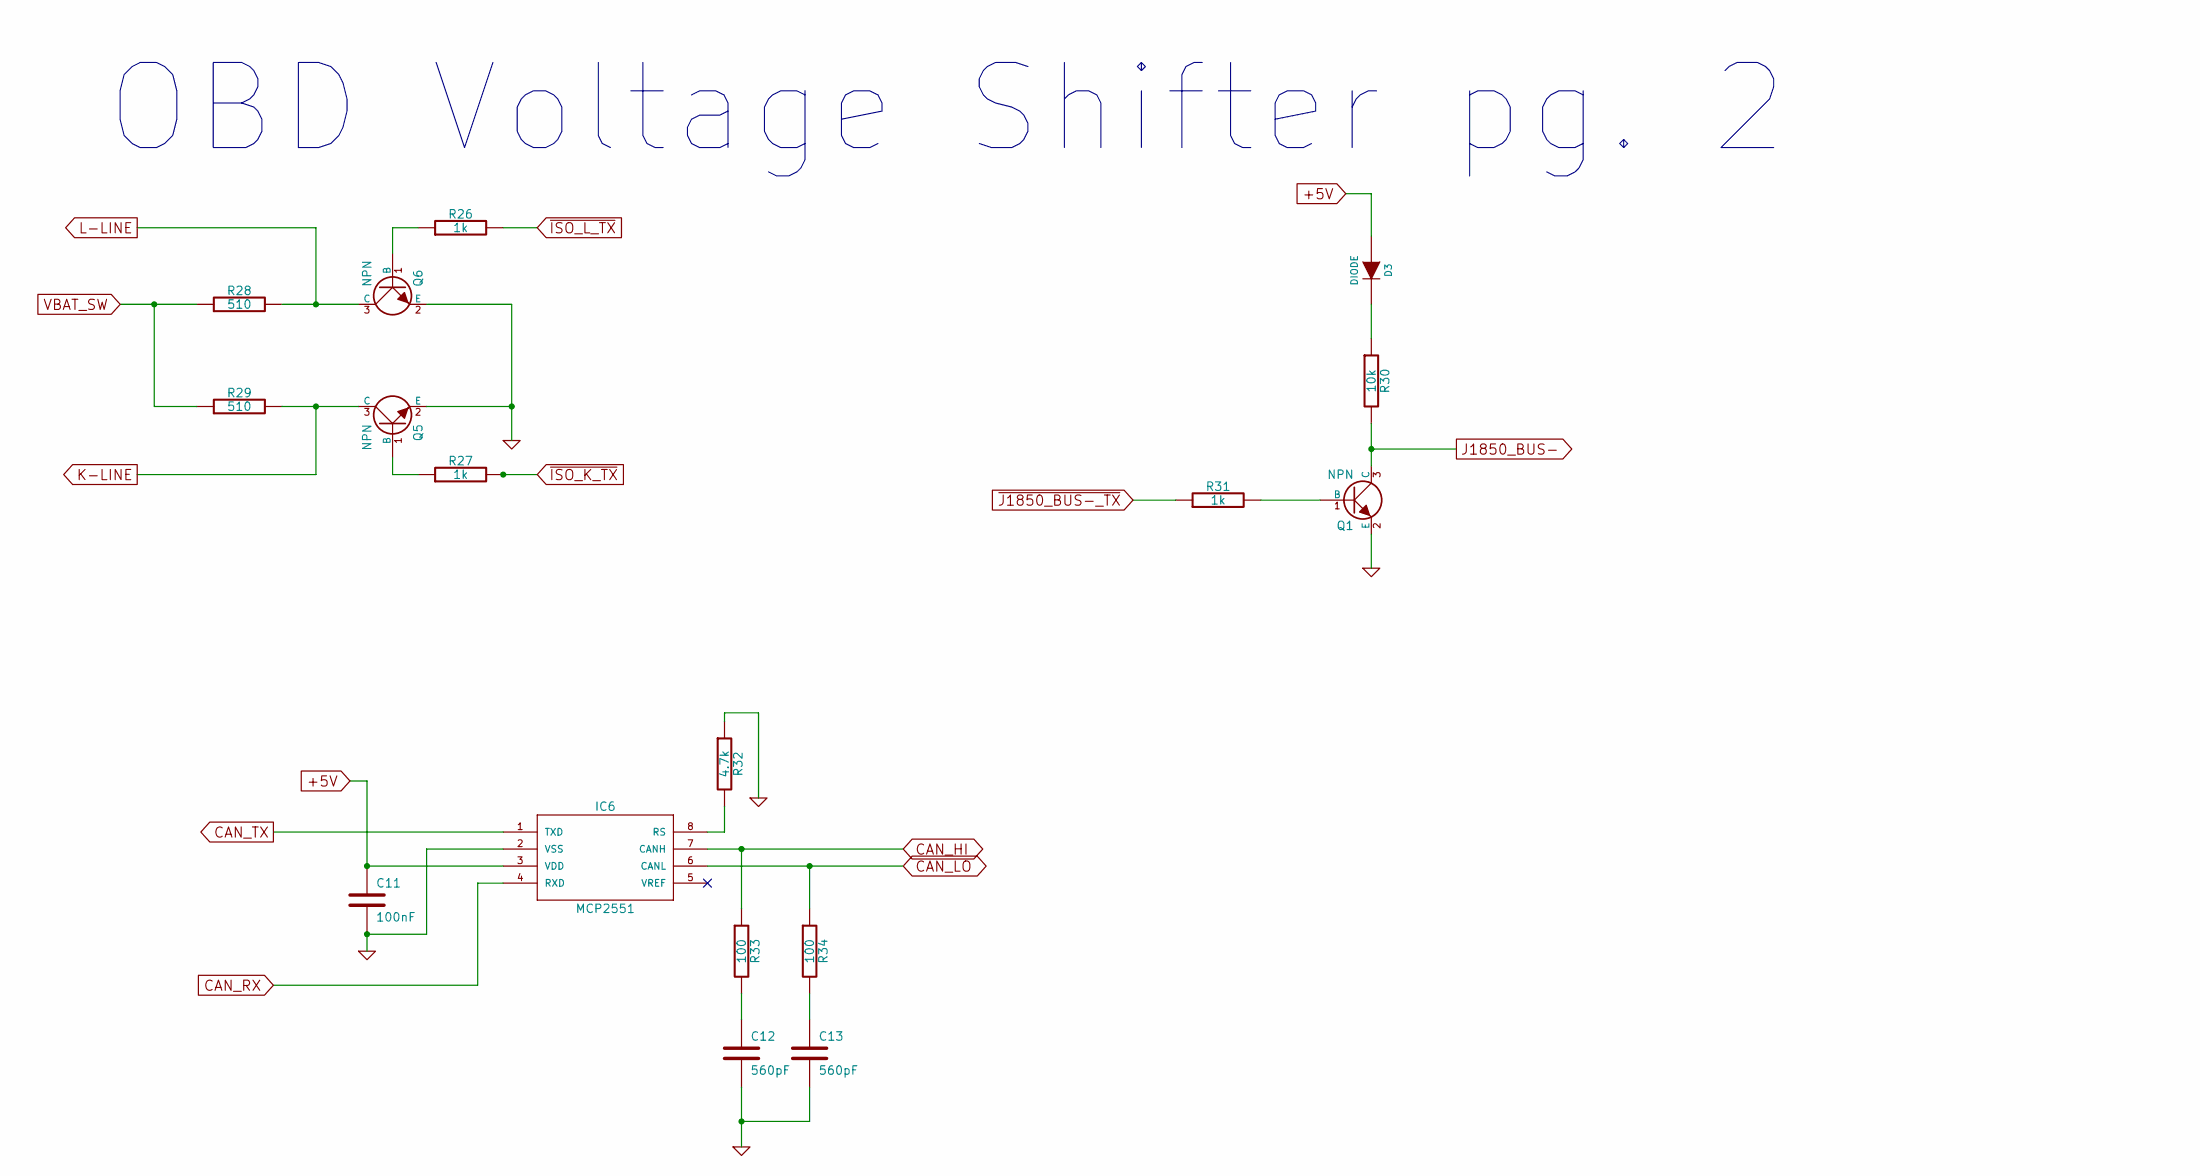
[picture p44: schematic OBD_Voltage_Shifter2.sch]

Parts:
C11: 100nF
C12, C13: 560pF
D3: DIODE
IC6: MCP2551; SparkFun-SO08
Q1, Q5, Q6: NPN
R26, R27, R31: 1k
R28, R29: 510
R30: 10k
R32: 4.7k
R33, R34: 100

Connections:
+5V: C11.1, D3.A, IC6.3 (VDD)
CAN_HI: IC6.7 (CANH), R33.1
CAN_LO: IC6.6 (CANL), R34.1
CAN_RX: IC6.4 (RXD)
CAN_TX: IC6.1 (TXD)
GND: C11.2, C12.2, C13.2, IC6.2 (VSS), Q1.2 (E), Q5.2 (E), Q6.2 (E), R32.1
J1850_BUS-: Q1.3 (C), R30.2
K-LINE: Q5.3 (C), R29.2
L-LINE: Q6.3 (C), R28.2
unnamed: C12.1, R33.2
unnamed: C13.1, R34.2
unnamed: D3.C, R30.1
unnamed: IC6.8 (RS), R32.2
unnamed: Q1.1 (B), R31.2
unnamed: Q5.1 (B), R27.1
unnamed: Q6.1 (B), R26.1
VBAT_SW: R28.1, R29.1
~ISO_K_TX: R27.2
~ISO_L_TX: R26.2
~J1850_BUS-_TX: R31.1

Notes on the sheet:
OBD Voltage Shifter pg. 2
