zanylane/obdii-gps-heads-up-display/KiCad/OBD_Voltage_Shifter.sch

## KiCad design KiCad/OBD_Voltage_Shifter.sch (2018-04-19)

Schematic: OBD_Voltage_Shifter.sch

Parts:
C10: 100nF
IC3: LM339
IC4: LM317
Q2: MOSFET_N
Q3: PNP
Q4: NPN
R8, R9, R10, R11, R12, R13, R14, R15, R16, R17, R18, R22, R24: 10K
R19: 240
R20: 866
R21: 374
R23: 2.2K

Notes on the sheet:
OBD Voltage Shifter
