zanylane/obdii-gps-heads-up-display/KiCad/Power_Supply.sch

## KiCad design KiCad/Power_Supply.sch (2018-04-19)

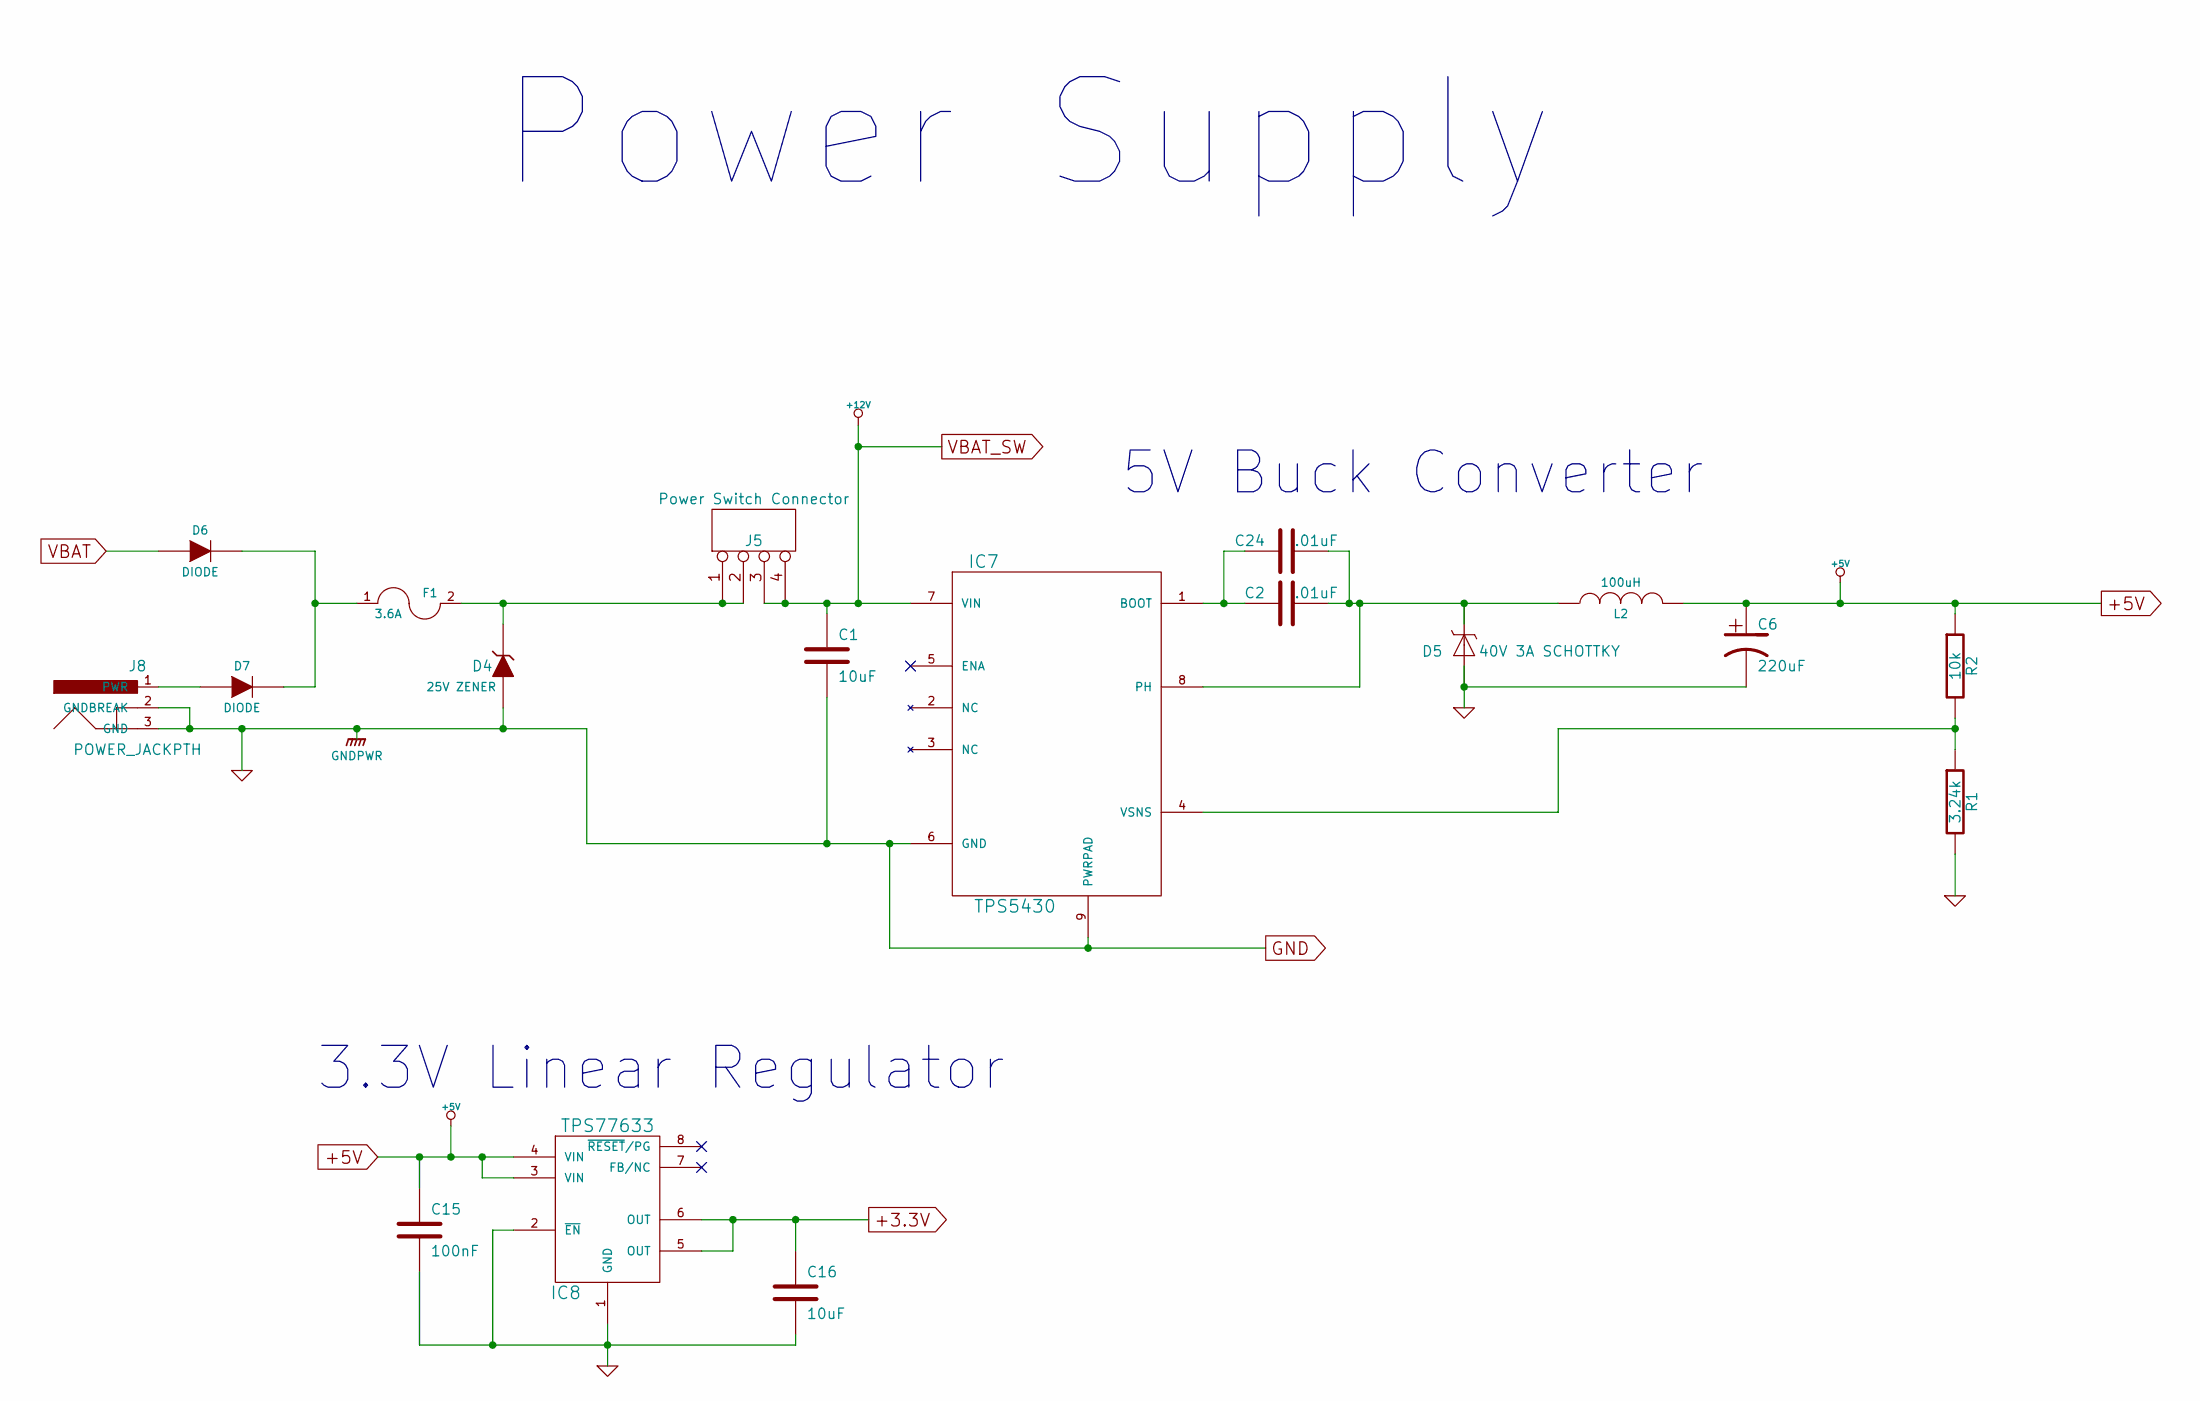
[picture p45: schematic Power_Supply.sch]

Parts:
C1, C16: 10uF
C2, C24: .01uF
C6: 220uF
C15: 100nF
D4: 25V ZENER
D5: 40V 3A SCHOTTKY; SparkFun-SMA-DIODE
D6, D7: DIODE
F1: 3.6A
IC7: TPS5430
IC8: TPS77633
J5: Power Switch Connector
J8: POWER_JACKPTH; SparkFun-POWER_JACK_PTH
L2: 100uH
R1: 3.24k
R2: 10k

Connections:
+3.3V: C16.1, IC8.5 (OUT), IC8.6 (OUT)
+5V: C6.1, C15.1, IC8.3 (VIN), IC8.4 (VIN), L2.2, R2.1
+12V: C1.1, IC7.7 (VIN), J5.3, J5.4
GND: C1.2, C6.2, C15.2, C16.2, D4.A, D5.A, IC7.6 (GND), IC7.9 (PWRPAD), IC8.1 (GND), IC8.2 (~EN), J8.2 (GNDBREAK), J8.3 (GND), R1.2
unnamed: C2.1, C24.1, IC7.1 (BOOT)
unnamed: C2.2, C24.2, D5.C, IC7.8 (PH), L2.1
unnamed: D4.C, F1.2, J5.1, J5.2
unnamed: D6.C, D7.C, F1.1
unnamed: D7.A, J8.1 (PWR)
unnamed: IC7.4 (VSNS), R1.1, R2.2
VBAT: D6.A

Notes on the sheet:
3.3V Linear Regulator
5V Buck Converter
Power Supply
