zanylane/obdii-gps-heads-up-display/KiCad/User_Interface.sch

## KiCad design KiCad/User_Interface.sch (2018-04-19)

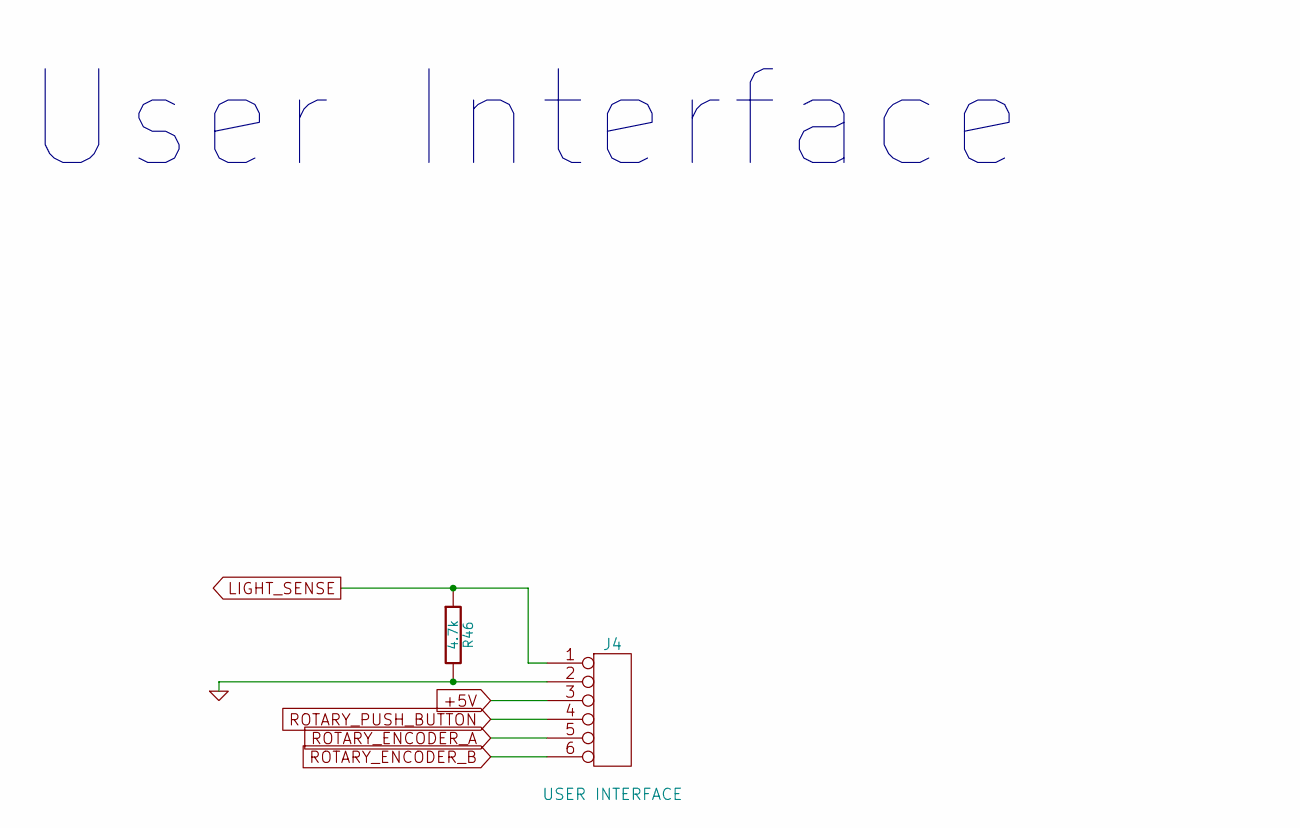
[picture p46: schematic User_Interface.sch]

Parts:
J4: USER INTERFACE
R46: 4.7k

Connections:
+5V: J4.3
GND: J4.2, R46.2
LIGHT_SENSE: J4.1, R46.1
ROTARY_ENCODER_A: J4.5
ROTARY_ENCODER_B: J4.6
ROTARY_PUSH_BUTTON: J4.4

Notes on the sheet:
User Interface
