zanylane/obdii-gps-heads-up-display/Arduino/ht1632c.cpp

#include <avr/io.h>
#include <avr/wdt.h>
#include <avr/pgmspace.h>
#include "Print.h"

#undef abs
#include <stdlib.h>

#define ht1632c_lib
#include "ht1632c.h"
#include "font.h"

//void ht1632c::_clk_pulse(byte num)
/*
void _clk_pulse(byte num)
{
  while(num--)
  {
    _clk_set();
    _clk_clr();
  }
}
*/

word inline pow2(byte exp)
{
  word result = 1;

  while(exp--)
    result *= 2;

  return result;
}

ht1632c::ht1632c(const byte geometry, const byte number)
{
  if (geometry != GEOM_32x16) return;
  bicolor = true;
  x_max = (32 * number) - 1;
  y_max = 15;
  cs_max = 4 * number;
  framesize = 32 * cs_max;
  framebuffer = (byte*) malloc(framesize);
  // setfont(FONT_5x7W);
  x_cur = 0;
  y_cur = 0;

  _data_out();
  _wr_out();
  _clk_out();
  _cs_out();
  setup();
}

/*
void ht1632class::begin(const byte data, const byte wr, const byte clk, const byte cs, byte geometry, byte number = 1)
{
  if (geometry != GEOM_32x16) return;
  bicolor = true;
  x_max = (32 * number) - 1;
  y_max = 15;
  cs_max = 4 * number;
  framesize = 32 * cs_max;
  framebuffer = (byte*) malloc(framesize);

  _data = _pin(data);
  _wr = _pin(wr);
  _clk = _pin(clk);
  _cs = _pin(cs);

  setup();
}
*/
/*
void ht1632class::begin(byte data, byte wr, byte cs1, byte cs2, byte cs3, byte cs4, byte geometry, byte number = 1)
{
  if ((geometry != GEOM_32x8) || (geometry != GEOM_24x16)) return;
  bicolor = false;
  cs_max = number;
  if (geometry == GEOM_32x8) {
    framesize = 64 * cs_max;
    x_max = (32 * number) - 1;
    y_max = 7;
  }
  if (geometry == GEOM_24x16) {
    framesize = 96 * cs_max;
    x_max = (24 * number) - 1;
    y_max = 15;
  }
  framebuffer = (byte*) malloc(framesize);

  ht1632_data.pin = data;
  ht1632_wr.pin = wr;
  ht1632_clk.pin = 0;

  setup();
}
*/
/*
void ht1632c::chipselect(byte cs)
{
  if (cs == HT1632_CS_ALL) { // Enable all ht1632class
    _cs_clr();
    _clk_pulse(cs_max);
  } else if (cs == HT1632_CS_NONE) { //Disable all ht1632classs
    _cs_set();
    _clk_pulse(cs_max);
  } else {
    _cs_clr();
    _clk_pulse(1);
    _cs_set();
    _clk_pulse(cs - 1);
  }
}

void ht1632c::writebits (byte bits, byte msb)
{
  while (msb) {
    !!(bits & msb) ? _data_set() : _data_clr();
    _wr_clr();
    _wr_set();
    msb >>= 1;
  }
}
*/
void ht1632c::sendcmd(byte cs, byte command)
{
  _chipselect(cs);
  _writebits(HT1632_ID_CMD, HT1632_ID_LEN);
  _writebits(command, HT1632_CMD_LEN);
  _writebits(0, 1);
  _chipselect(HT1632_CS_NONE);
}

/* HT1632Cs based display initialization  */

void ht1632c::setup()
{
/*
  _out(_data);
  _out(_wr);
  _out(_clk);
  _out(_cs);
*/
  noInterrupts();
  sendcmd(HT1632_CS_ALL, HT1632_CMD_SYSDIS);
  sendcmd(HT1632_CS_ALL, HT1632_CMD_COMS00);
  sendcmd(HT1632_CS_ALL, HT1632_CMD_MSTMD);
  sendcmd(HT1632_CS_ALL, HT1632_CMD_RCCLK);
  sendcmd(HT1632_CS_ALL, HT1632_CMD_SYSON);
  sendcmd(HT1632_CS_ALL, HT1632_CMD_LEDON);
  sendcmd(HT1632_CS_ALL, HT1632_CMD_PWM);
  interrupts();
}

/* set the display brightness */

void ht1632c::pwm(byte value)
{
  sendcmd(HT1632_CS_ALL, HT1632_CMD_PWM | value);
}

/* write the framebuffer to the display - to be used after one or more textual or graphic functions */

void ht1632c::sendframe()
{
  byte data, offs, cs;
  word addr;

  noInterrupts();
  for (cs = 0; cs < cs_max; cs++)
  {
    _chipselect(cs+1);
    _writebits(HT1632_ID_WR, HT1632_ID_LEN);
    _writebits(0, HT1632_ADDR_LEN);
    addr = cs + (cs & 2) - 2*!!(cs & 4);
    addr *= 16;
    for (offs = 0; offs < 16; offs++)
      _writebits(framebuffer[addr+offs], HT1632_DATA_LEN);
    for (offs = 0; offs < 16; offs++)
      _writebits(framebuffer[addr+offs+128], HT1632_DATA_LEN);
    _chipselect(HT1632_CS_NONE);
  }
  interrupts();
}

/* clear the display */

void ht1632c::clear()
{
  x_cur = 0;
  y_cur = 0;
  memset(framebuffer, 0, framesize);
  sendframe();
}

void ht1632c::update_framebuffer(word addr, byte target_bitval, byte pixel_bitval)
{
  byte &v = framebuffer[addr];
  (target_bitval) ? v |= pixel_bitval : v &= ~pixel_bitval;
}

/* put a single pixel in the coordinates x, y */

void ht1632c::plot (byte x, byte y, byte color)
{
  byte bitval;
  word addr;

  if (x < 0 || x > x_max || y < 0 || y > y_max)
    return;

  if (color != BLACK && color != GREEN && color != RED && color != ORANGE)
    return;

  bitval = 128 >> (y & 7);
  addr = (x & 63) + 8*(y & ~7);

  update_framebuffer(addr, (color & GREEN), bitval);
  update_framebuffer(addr+128, (color & RED), bitval);
}

/* print a single character */

byte ht1632c::putchar(uint8_t x, uint8_t y, char c, byte color, byte attr)
{
  word dots, msb;

  if (x < -font_width || x > x_max + font_width || y < -font_height || y > y_max + font_height)
    return 0;
 
  register byte width = font_width;
  register byte height = font_height;

  c -= 32;
  msb = pow2(height-1);
  //attr = PROPORTIONAL; // TESTPOINT
 
  // some math with pointers... don't try this at home ;-)
  uint8_t *addr = font + c * width;
  uint16_t *waddr = wfont + c * width;
  for (register char col = 0; col < width; col++) {
    dots = (height > 8) ? pgm_read_word_near(waddr + col) : pgm_read_byte_near(addr + col);
    if (attr & PROPORTIONAL) {
      if (dots)
      {
        for (register char row = 0; row < height; row++) {
          if (dots & (msb>>row)) {
            plot(x+col, y+row, (color & MULTICOLOR) ? random(1,4) : color);
          } else {
            plot(x+col, y+row, BLACK);
          }
        }
      } else {
        width--;
        x--;
      }
    } else {
      for (register char row = 0; row < height; row++) {
        if (dots & (msb>>row)) {
          plot(x+col, y+row, (color & MULTICOLOR) ? random(1,4) : color);
        } else {
          plot(x+col, y+row, BLACK);
        }
      }
    }
  }
  if (attr & PROPORTIONAL)
  {
    // TODO!
  } else {
    for (register char row = 0; row < height; row++) {
      plot(x + width, y+row, BLACK);
    }
  }
  return width;
}

/* put a bitmap in the coordinates x, y */

void ht1632c::putbitmap(uint8_t x, uint8_t y, uint16_t *bitmap, byte w, byte h, byte color)
{
  if (x < -w || x > x_max + w || y < -h || y > y_max + h)
    return;
  word msb = pow2(w-1);
  for (byte row = 0; row < h; row++)
  {
    uint16_t dots = pgm_read_word_near(&bitmap[row]);
    if (dots && color)
      for (byte col = 0; col < w; col++)
      {
        if (dots & (msb>>col))
          plot(x+col, y+row, color);
        else
          plot(x+col, y+row, BLACK);
      }
  }
}

/* text only scrolling functions */

void ht1632c::hscrolltext(int y, char *text, byte color, int delaytime, int times, byte dir)
{
  byte showcolor;
  int x, len = strlen(text);
  register byte width = font_width;
  width++;
 
  while (times){
    for ((dir) ? x = - (len * width) : x = x_max; (dir) ? x <= x_max : x > - (len * width); (dir) ? x++ : x--)
    {
      for (int i = 0; i < len; i++)
      {
        showcolor = (color & RANDOMCOLOR) ? random(1,4) : color;
        showcolor = ((color & BLINK) && (x & 2)) ? BLACK : (showcolor & ~BLINK);
        putchar(x + width * i,  y, text[i], showcolor);
      }
      sendframe();
      delay(delaytime);
    }
    times--;
  }
}

void ht1632c::vscrolltext(int x, char *text, byte color, int delaytime, int times, byte dir)
{
  byte showcolor;
  int y, len = strlen(text);
  register byte width = font_width;
  width++;

  while (times) {
    for ((dir) ? y = - font_height : y = y_max + 1; (dir) ? y <= y_max + 1 : y > - font_height; (dir) ? y++ : y--)
    {
      for (int i = 0; i < len; i++)
      {
        showcolor = (color & RANDOMCOLOR) ? random(1,4) : color;
        showcolor = ((color & BLINK) && (y & 2)) ? BLACK : (showcolor & ~BLINK);
        putchar(x + font_width * i,  y, text[i], showcolor);
      }
      // quick and dirty fix to avoid wakes
      line (x, y - 1, x + font_width * len, y - 1, BLACK);
      sendframe();
      delay(delaytime);
    }
    times--;
  }
}

// void ht1632c::putInt(int x, int y, int num, byte color)
// {
  // String stringOne = String(num);
  // char charBuf[50];
  // stringOne.toCharArray(charBuf,50);
  // byte showcolor;
  // int len = strlen(charBuf);
  // register byte width = font_width;
  // width++;
 
      // for (int i = 0; i < len; i++)
      // {
			// showcolor = (color & RANDOMCOLOR) ? random(1,4) : color;
			// showcolor = ((color & BLINK) && (x & 2)) ? BLACK : (showcolor & ~BLINK);
			// putchar(x + width * i,  y, charBuf[i], showcolor);
      // }
      // sendframe();
// }

void ht1632c::putInt(uint8_t y, int num, byte color, boolean left)
{
  String stringOne = String(num);
  char charBuf[6];
  stringOne.toCharArray(charBuf,6);
  byte showcolor;
  uint8_t len = strlen(charBuf);
  if(len>5) len = 5;
  static uint8_t lastLength = 0;
  register byte width = font_width;
  width += 1;
  uint8_t x;
  uint8_t k = 7;
  if(left){
    k = 1;
    putchar(19,y,' ',BLACK);
  }
  if(len==5){
    k = 1;
  } else{
    putchar(1,y,' ',BLACK);
  }
  int8_t diff = lastLength - len;
  if(diff>0){
    for(uint8_t i = 0;i<diff;i++){
      x = k + width * (lastLength - (i + 1));
      putchar(x, y, ' ', BLACK);
    }
  }
 
  for (uint8_t i = 0; i<len; i++){
    x = k + width * i;
    showcolor = (color & RANDOMCOLOR) ? random(1,4) : color;
    showcolor = ((color & BLINK) && (x & 2)) ? BLACK : (showcolor & ~BLINK);
    putchar(x,  y, charBuf[i], showcolor);
  }
  sendframe();
  lastLength = len;
}

/* choose/change font to use (for next putchar) */

void ht1632c::setfont(byte userfont)
{
  switch(userfont) {

#ifdef FONT_4x6
    case FONT_4x6:
        font = (uint8_t *) &font_4x6[0];
        font_width = 4;
        font_height = 6;
        break;
#endif
#ifdef FONT_4x6_Mirrored
    case FONT_4x6_Mirrored:
        font = (uint8_t *) &font_4x6m[0];
        font_width = 4;
        font_height = 6;
        break;
#endif
#ifdef FONT_5x7
    case FONT_5x7:
        font = (uint8_t *) &font_5x7[0];
        font_width = 5;
        font_height = 7;
        break;
#endif
#ifdef FONT_5x8
    case FONT_5x8:
        font = (uint8_t *) &font_5x8[0];
        font_width = 5;
        font_height = 8;
        break;
#endif
#ifdef FONT_5x7W
    case FONT_5x7W:
        font = (uint8_t *) &font_5x7w[0];
        font_width = 5;
        font_height = 8;
        break;
#endif
#ifdef FONT_5x7W_Mirrored
    case FONT_5x7W_Mirrored:
        font = (uint8_t *) &font_5x7wm[0];
        font_width = 5;
        font_height = 8;
        break;
#endif
#ifdef FONT_6x10
    case FONT_6x10:
        wfont = (uint16_t *) &font_6x10[0];
        font_width = 6;
        font_height = 10;
        break;
#endif
#ifdef FONT_6x12
    case FONT_6x12:
        wfont = (uint16_t *) &font_6x12[0];
        font_width = 6;
        font_height = 12;
        break;
#endif
#ifdef FONT_6x13
    case FONT_6x13:
        wfont = (uint16_t *) &font_6x13[0];
        font_width = 6;
        font_height = 13;
        break;
#endif
#ifdef FONT_6x13B
    case FONT_6x13B:
        wfont = (uint16_t *) &font_6x13B[0];
        font_width = 6;
        font_height = 13;
        break;
#endif
#ifdef FONT_6x13O
    case FONT_6x13O:
        wfont = (uint16_t *) &font_6x13O[0];
        font_width = 6;
        font_height = 13;
        break;
#endif
#ifdef FONT_6x9
    case FONT_6x9:
        wfont = (uint16_t *) &font_6x9[0];
        font_width = 6;
        font_height = 9;
        break;
#endif
#ifdef FONT_7x13
    case FONT_7x13:
        wfont = (uint16_t *) &font_7x13[0];
        font_width = 7;
        font_height = 13;
        break;
#endif
#ifdef FONT_7x13B
    case FONT_7x13B:
        wfont = (uint16_t *) &font_7x13B[0];
        font_width = 7;
        font_height = 13;
        break;
#endif
#ifdef FONT_7x13O
    case FONT_7x13O:
        wfont = (uint16_t *) &font_7x13O[0];
        font_width = 7;
        font_height = 13;
        break;
#endif
#ifdef FONT_7x14
    case FONT_7x14:
        wfont = (uint16_t *) &font_7x14[0];
        font_width = 7;
        font_height = 14;
        break;
#endif
#ifdef FONT_7x14B
    case FONT_7x14B:
        wfont = (uint16_t *) &font_7x14B[0];
        font_width = 7;
        font_height = 14;
        break;
#endif
#ifdef FONT_8x8
    case FONT_8x8:
        font = (uint8_t *) &font_8x8[0];
        font_width = 8;
        font_height = 8;
        break;
#endif
#ifdef FONT_8x13
    case FONT_8x13:
        wfont = (uint16_t *) &font_8x13[0];
        font_width = 8;
        font_height = 13;
        break;
#endif
#ifdef FONT_8x13B
    case FONT_8x13B:
        wfont = (uint16_t *) &font_8x13B[0];
        font_width = 8;
        font_height = 13;
        break;
#endif
#ifdef FONT_8x13O
    case FONT_8x13O:
        wfont = (uint16_t *) &font_8x13O[0];
        font_width = 8;
        font_height = 13;
        break;
#endif
#ifdef FONT_9x15
    case FONT_9x15:
        wfont = (uint16_t *) &font_9x15[0];
        font_width = 9;
        font_height = 15;
        break;
#endif
#ifdef FONT_9x15B
    case FONT_9x15B:
        wfont = (uint16_t *) &font_9x15b[0];
        font_width = 9;
        font_height = 15;
        break;
#endif
#ifdef FONT_8x16
    case FONT_8x16:
        wfont = (uint16_t *) &font_8x16[0];
        font_width = 8;
        font_height = 16;
        break;
#endif
#ifdef FONT_8x16B
    case FONT_8x16B:
        wfont = (uint16_t *) &font_8x16b[0];
        font_width = 8;
        font_height = 16;
        break;
#endif
  }
}

/* graphic primitives based on Bresenham's algorithms */

void ht1632c::line(int x0, int y0, int x1, int y1, byte color)
{
  int dx =  abs(x1-x0), sx = x0<x1 ? 1 : -1;
  int dy = -abs(y1-y0), sy = y0<y1 ? 1 : -1;
  int err = dx+dy, e2; /* error value e_xy */

  for(;;) {
    plot(x0, y0, color);
    if (x0 == x1 && y0 == y1) break;
    e2 = 2*err;
    if (e2 >= dy) { err += dy; x0 += sx; } /* e_xy+e_x > 0 */
    if (e2 <= dx) { err += dx; y0 += sy; } /* e_xy+e_y < 0 */
  }
}

void ht1632c::rect(int x0, int y0, int x1, int y1, byte color)
{
  line(x0, y0, x0, y1, color); /* left line   */
  line(x1, y0, x1, y1, color); /* right line  */
  line(x0, y0, x1, y0, color); /* top line    */
  line(x0, y1, x1, y1, color); /* bottom line */
}

void ht1632c::circle(int xm, int ym, int r, byte color)
{
  int x = -r, y = 0, err = 2-2*r; /* II. Quadrant */
  do {
    plot(xm - x, ym + y, color); /*   I. Quadrant */
    plot(xm - y, ym - x, color); /*  II. Quadrant */
    plot(xm + x, ym - y, color); /* III. Quadrant */
    plot(xm + y, ym + x, color); /*  IV. Quadrant */
    r = err;
    if (r >  x) err += ++x * 2 + 1; /* e_xy+e_x > 0 */
    if (r <= y) err += ++y * 2 + 1; /* e_xy+e_y < 0 */
  } while (x < 0);
}

void ht1632c::ellipse(int x0, int y0, int x1, int y1, byte color)
{
  int a = abs(x1 - x0), b = abs(y1 - y0), b1 = b & 1; /* values of diameter */
  long dx = 4 * (1 - a) * b * b, dy = 4 * (b1 + 1) * a * a; /* error increment */
  long err = dx + dy + b1 * a * a, e2; /* error of 1.step */

  if (x0 > x1) { x0 = x1; x1 += a; } /* if called with swapped points */
  if (y0 > y1) y0 = y1; /* .. exchange them */
  y0 += (b + 1) / 2; /* starting pixel */
  y1 = y0 - b1;
  a *= 8 * a;
  b1 = 8 * b * b;

  do {
    plot(x1, y0, color); /*   I. Quadrant */
    plot(x0, y0, color); /*  II. Quadrant */
    plot(x0, y1, color); /* III. Quadrant */
    plot(x1, y1, color); /*  IV. Quadrant */
    e2 = 2 * err;
    if (e2 >= dx) { x0++; x1--; err += dx += b1; } /* x step */
    if (e2 <= dy) { y0++; y1--; err += dy += a; }  /* y step */
  } while (x0 <= x1);

  while (y0 - y1 < b) {  /* too early stop of flat ellipses a=1 */
    plot(x0 - 1, ++y0, color); /* -> complete tip of ellipse */
    plot(x0 - 1, --y1, color);
  }
}

void ht1632c::bezier(int x0, int y0, int x1, int y1, int x2, int y2, byte color)
{
  int sx = x0 < x2 ? 1 : -1, sy = y0<y2 ? 1 : -1; /* step direction */
  int cur = sx * sy * ((x0 - x1) * (y2 - y1) - (x2 - x1) * (y0 - y1)); /* curvature */
  int x = x0 - 2 * x1 + x2, y = y0 - 2 * y1 + y2, xy = 2 * x * y * sx * sy;
                                /* compute error increments of P0 */
  long dx = (1 - 2 * abs(x0 - x1)) * y * y + abs(y0 - y1) * xy - 2 * cur * abs(y0 - y2);
  long dy = (1 - 2 * abs(y0 - y1)) * x * x + abs(x0 - x1) * xy + 2 * cur * abs(x0 - x2);
                                /* compute error increments of P2 */
  long ex = (1 - 2 * abs(x2 - x1)) * y * y + abs(y2 - y1) * xy + 2 * cur * abs(y0 - y2);
  long ey = (1 - 2 * abs(y2 - y1)) * x * x + abs(x2 - x1) * xy - 2 * cur * abs(x0 - x2);

  if (cur == 0) { line(x0, y0, x2, y2, color); return; } /* straight line */
     
  x *= 2 * x; y *= 2 * y;
  if (cur < 0) {                             /* negated curvature */
    x = -x; dx = -dx; ex = -ex; xy = -xy;
    y = -y; dy = -dy; ey = -ey;
  }
  /* algorithm fails for almost straight line, check error values */
  if (dx >= -y || dy <= -x || ex <= -y || ey >= -x) {        
    line(x0, y0, x1, y1, color);                /* simple approximation */
    line(x1, y1, x2, y2, color);
    return;
  }
  dx -= xy; ex = dx+dy; dy -= xy;              /* error of 1.step */

  for(;;) {                                         /* plot curve */
    plot(x0, y0, color);
    ey = 2 * ex - dy;                /* save value for test of y step */
    if (2 * ex >= dx) {                                   /* x step */
      if (x0 == x2) break;
      x0 += sx; dy -= xy; ex += dx += y;
    }
    if (ey <= 0) {                                      /* y step */
      if (y0 == y2) break;
      y0 += sy; dx -= xy; ex += dy += x;
    }
  }
}

/* returns the pixel value (RED, GREEN, ORANGE or 0/BLACK) of x, y coordinates */

byte ht1632c::getpixel(byte x, byte y)
{
  word addr = (x & 63) + 8*(y & ~7);
  byte g = framebuffer[addr];
  byte r = framebuffer[addr+128];
  byte valbit = 1 << (7 - y & 7);
  return (g & valbit) ? GREEN : BLACK | (r & valbit) ? RED : BLACK;
}

/* boundary flood fill with the seed in x, y coordinates */

void ht1632c::fill_r(byte x, byte y, byte color)
{
  if (x > x_max) return;
  if (y > y_max) return;
  if(!getpixel(x, y))
  {
    plot(x, y, color);
    fill_r(++x, y ,color);
    x = x - 1;
    if (x > x_max) return;
    fill_r(x, y-1, color);
    fill_r(x, y+1, color);
  }
}

void ht1632c::fill_l(byte x, byte y, byte color)
{
  if (x > x_max) return;
  if (y > y_max) return;
  if(!getpixel(x, y))
  {
    plot(x, y, color);
    fill_l(--x, y, color);
    x = x + 1 ;
    fill_l(x, y-1, color);
    fill_l(x, y+1, color);
  }
}

void ht1632c::fill(byte x, byte y, byte color)
{
  fill_r(x, y, color);
  fill_l(x-1, y, color);
}

size_t ht1632c::write(uint8_t chr)
{
  byte x, y;
  if (chr == '\n') {
    //y_cur += font_height;
  } else {
    //x_cur += putchar(x_cur, y_cur, chr, GREEN, PROPORTIONAL);
    //x_cur = 0;
    //y_cur = 0;
  }
  //sendframe();
}

void ht1632c::write(const char *str)
{
  byte x, y;
  byte len = strlen(str);
  if (x_cur + font_width <= x_max)
    for (byte i = 0; i < len; i++)
    {
      if (str[i] == '\n') {
        y_cur += font_height;
        x_cur = 0;
        if (y_cur > y_max) break;
      } else {
        x_cur += putchar(x_cur, y_cur, str[i], GREEN, PROPORTIONAL);
        if (x_cur + font_width > x_max) break;
      }
    }
  //x_cur = 0;
  //y_cur = 0;
  sendframe();
}

/* calculate frames per second speed, for benchmark */

void ht1632c::profile() {
  const byte frame_interval = 50;
  static unsigned long last_micros = 0;
  static byte frames = 0;
  if (++frames == frame_interval) {
    fps = (frame_interval * 1000000) / (micros() - last_micros);
    frames = 0;
    last_micros = micros();
  }
}
