zanylane/obdii-gps-heads-up-display/(commit log)

2018-04-19 Add KiCad design files.
    [GPS_Module.sch, HeadsUpDisplay.brd, HeadsUpDisplay.csv, HeadsUpDisplay.sch, I2C_Bridge.sch, LED_Display.sch, Light_Sensor.sch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]
2018-04-19 Add Arduino Code
2018-04-19 Added BOM
    [BOM.ods]
2018-04-19 solidworks files
    [Assem1.SLDDRW, bottom.SLDDRW, box.SLDDRW, led_display.SLDDRW, pcb.SLDDRW]
